antmicro/artix-dc-scm/assets/previews/layer0.png

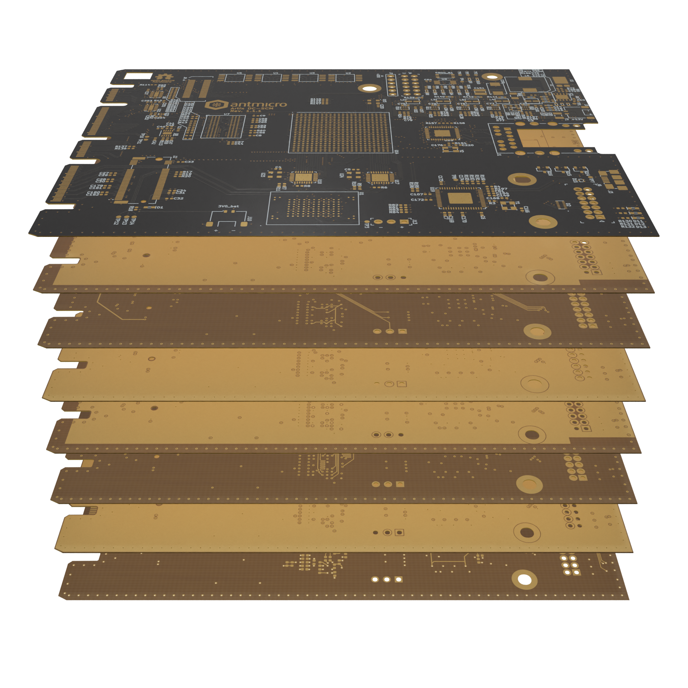
assets/previews/layer0.png
