antmicro/artix-dc-scm/assets/previews/layer1.png

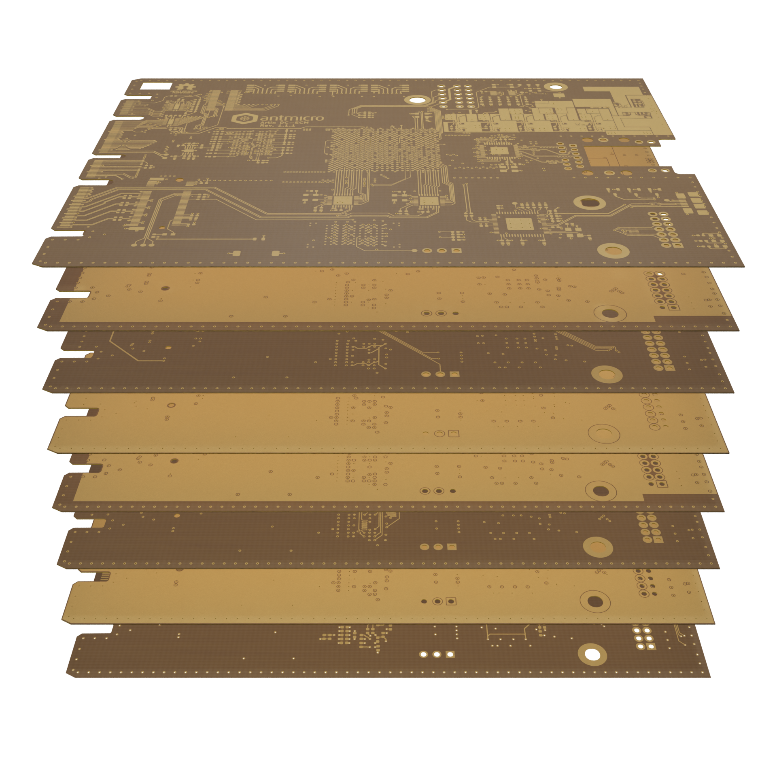
assets/previews/layer1.png
