antmicro/artix-dc-scm/assets/previews/layer1_thumbnail.png

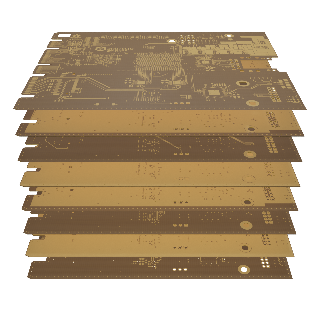
assets/previews/layer1_thumbnail.png
