antmicro/artix-dc-scm/assets/previews/layer2.png

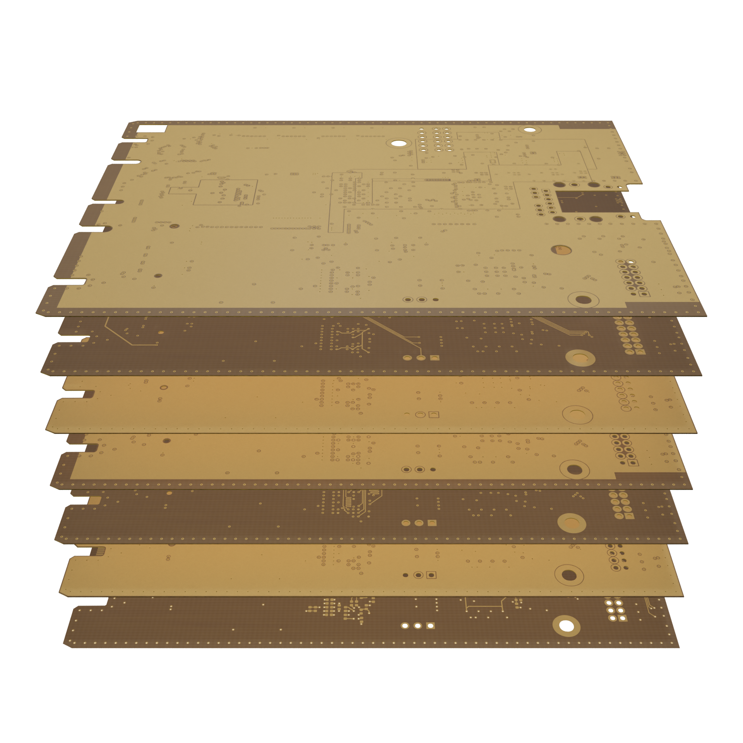
assets/previews/layer2.png
