antmicro/artix-dc-scm/assets/previews/layer3.png

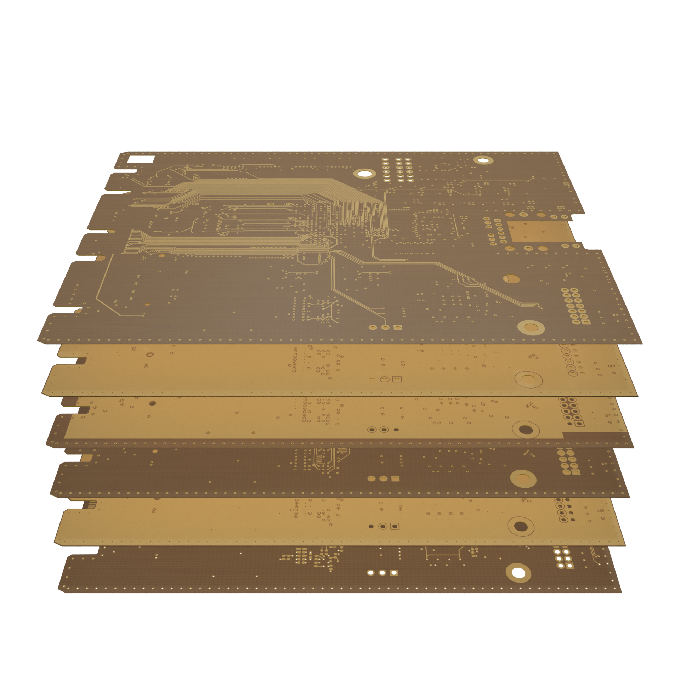
assets/previews/layer3.png
