antmicro/artix-dc-scm/assets/previews/layer3_thumbnail.png

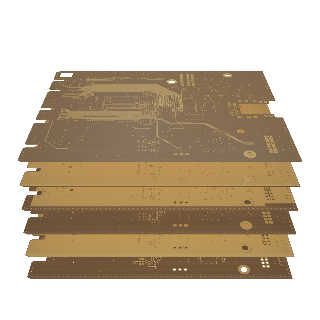
assets/previews/layer3_thumbnail.png
