antmicro/artix-dc-scm/assets/previews/layer4.png

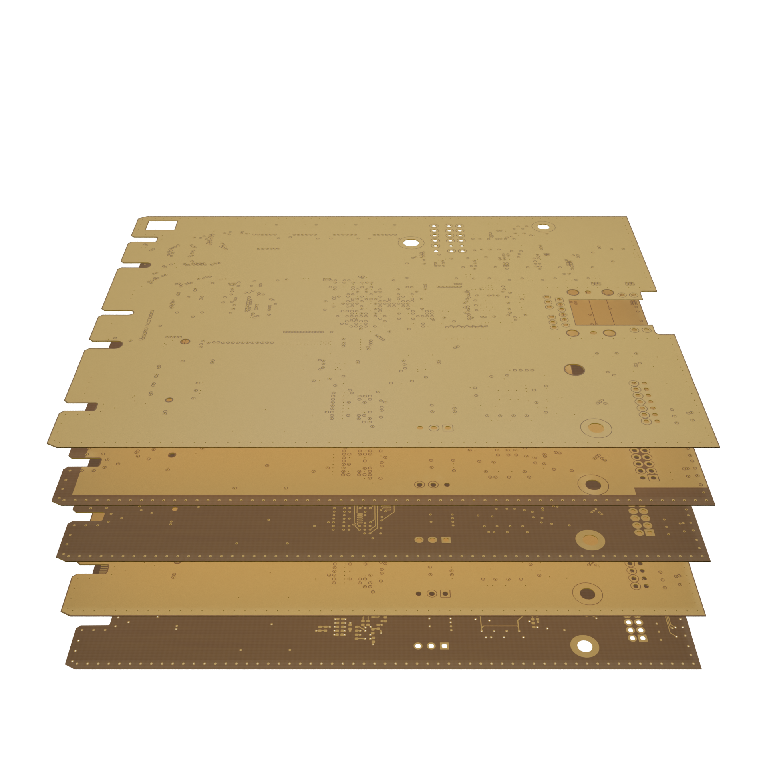
assets/previews/layer4.png
