antmicro/artix-dc-scm/assets/previews/layer6.png

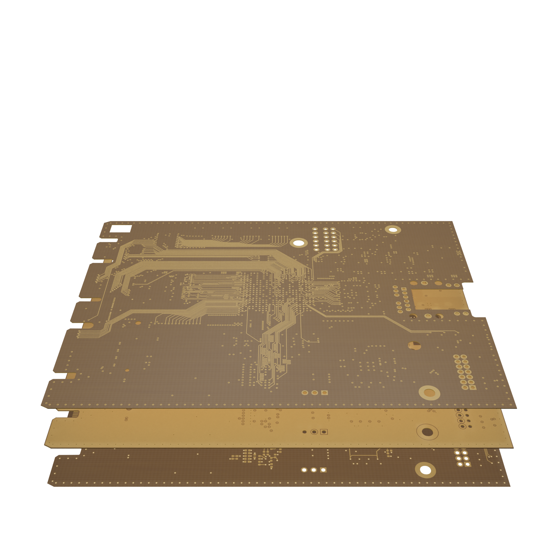
assets/previews/layer6.png
