antmicro/artix-dc-scm/assets/previews/layer7.png

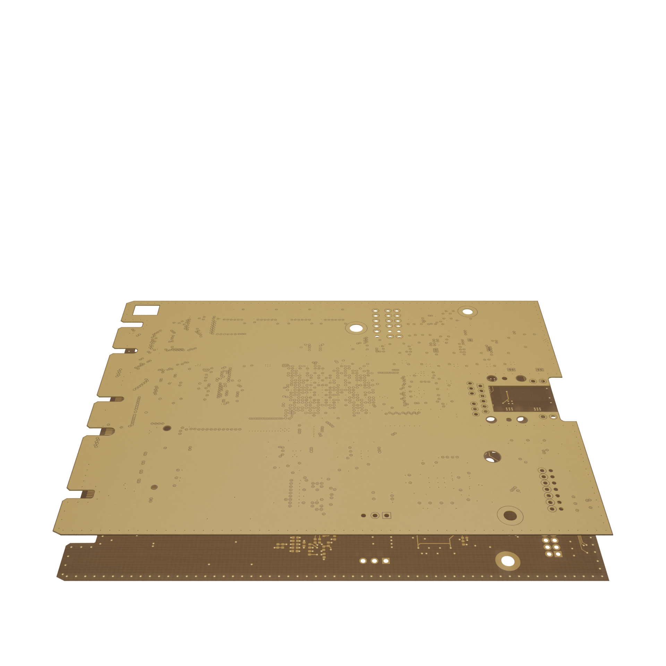
assets/previews/layer7.png
