antmicro/artix-dc-scm/assets/previews/layer8.png

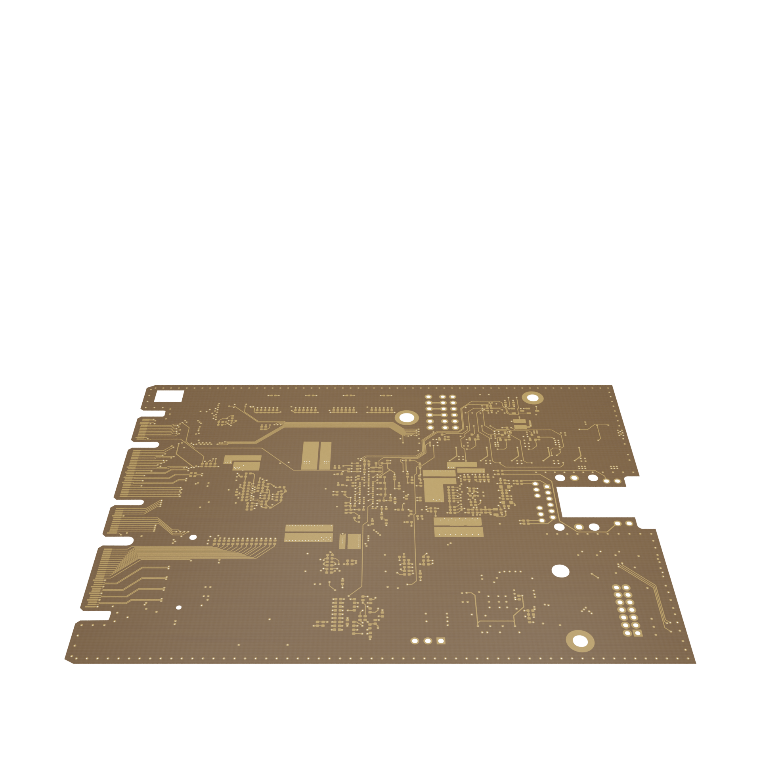
assets/previews/layer8.png
