antmicro/artix-dc-scm/assets/previews/leftB.png

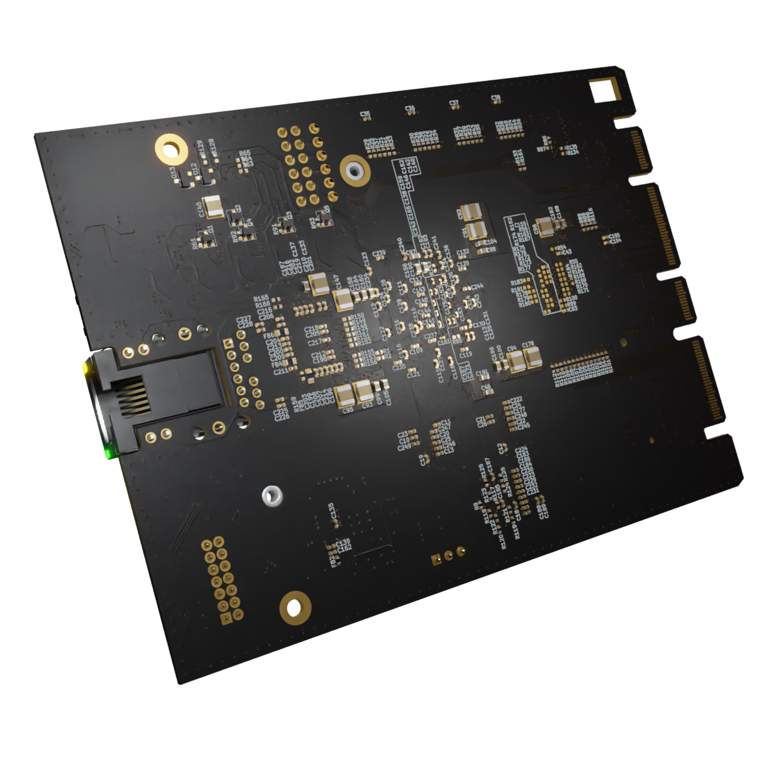
assets/previews/leftB.png
