antmicro/artix-dc-scm/assets/previews/leftT.png

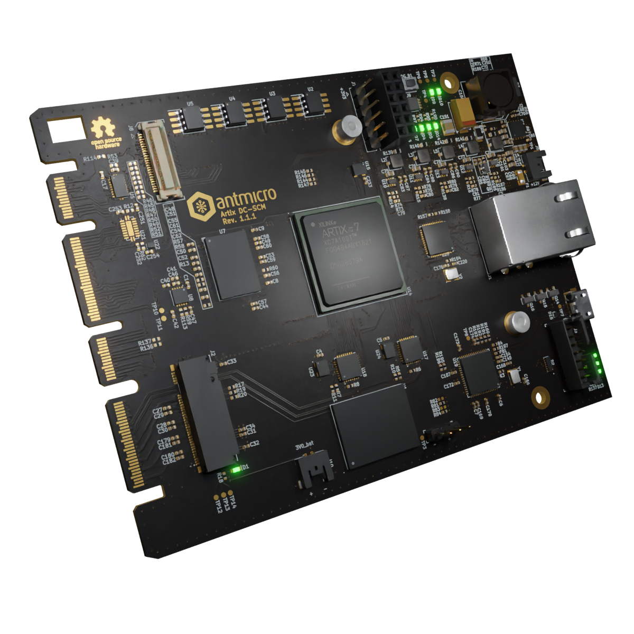
assets/previews/leftT.png
