antmicro/artix-dc-scm/assets/previews/orthoB.png

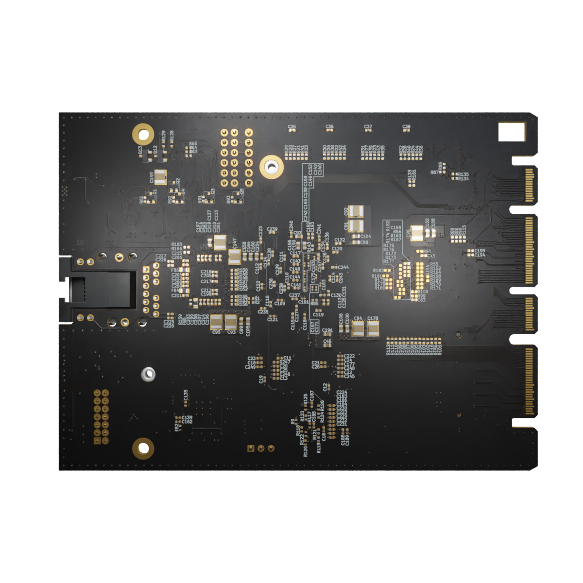
assets/previews/orthoB.png
