antmicro/artix-dc-scm/assets/previews/orthoT.png

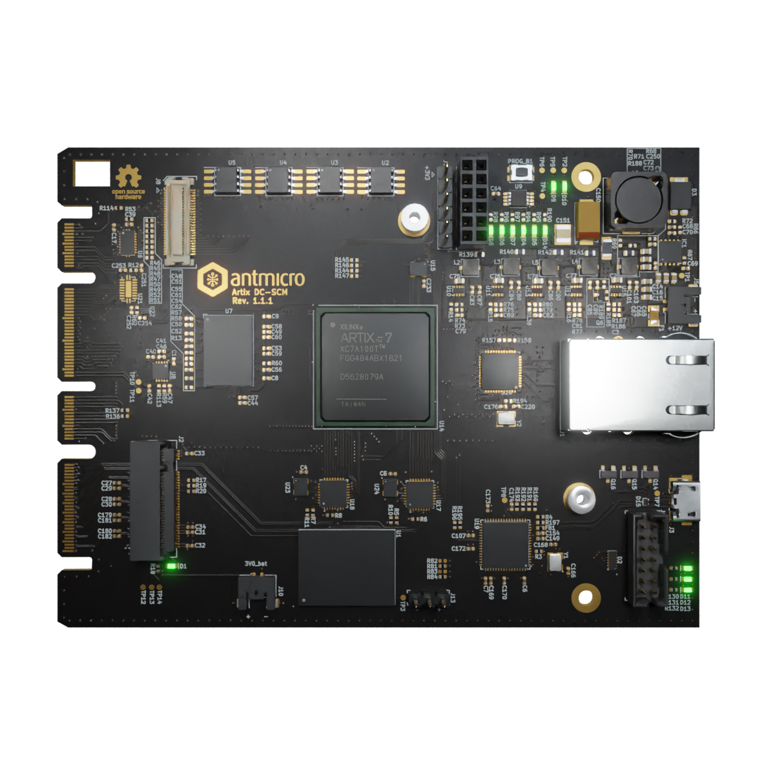
assets/previews/orthoT.png
