antmicro/artix-dc-scm/assets/previews/photoB.png

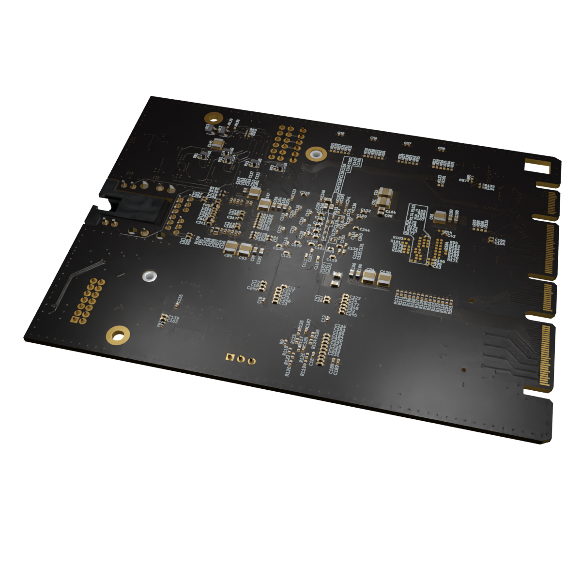
assets/previews/photoB.png
