antmicro/artix-dc-scm/assets/previews/photoT.png

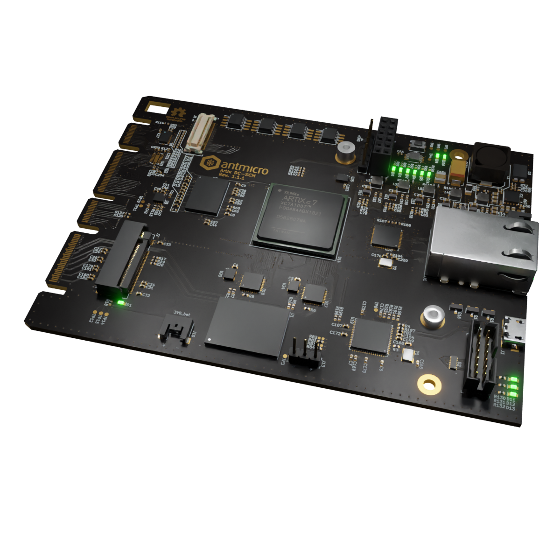
assets/previews/photoT.png
