antmicro/artix-dc-scm/assets/previews/rightB.png

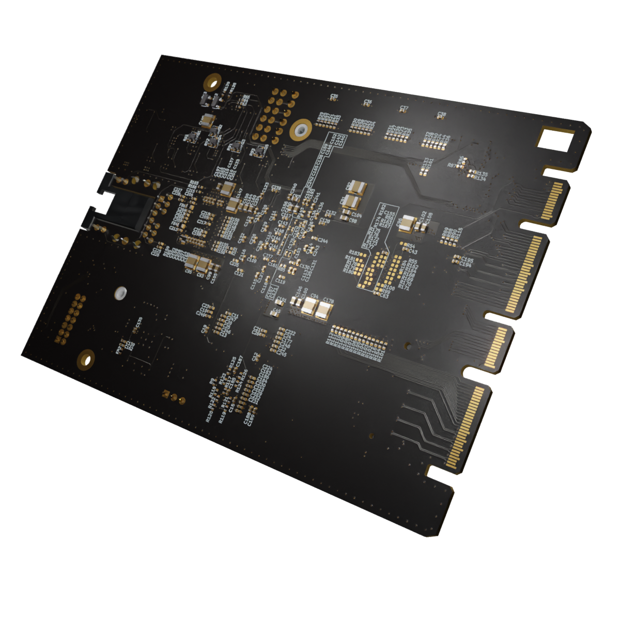
assets/previews/rightB.png
