antmicro/artix-dc-scm/assets/previews/rightT.png

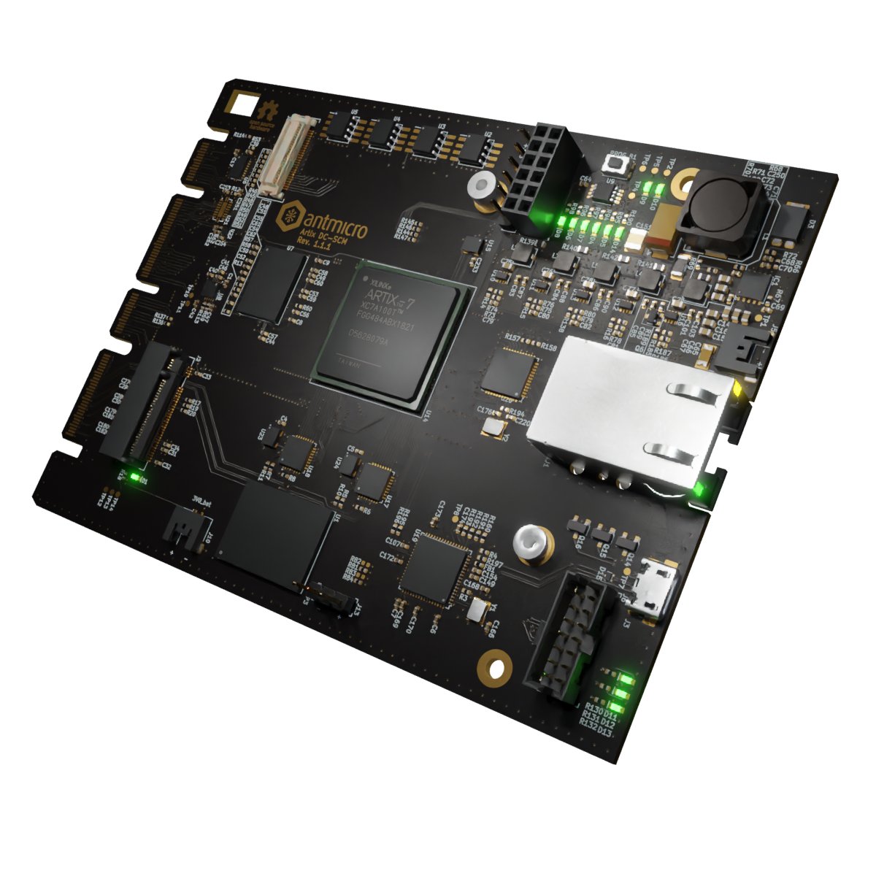
assets/previews/rightT.png
