antmicro/artix-dc-scm/img/diagram.png

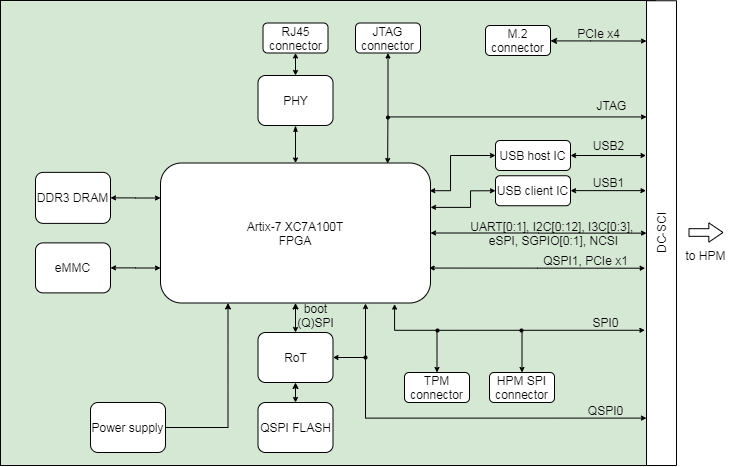
img/diagram.png
