antmicro/artix-dc-scm/(threads)

Thread 1 (2022-09-23):

i2c5 routed to incorrect DC-SCI pins, PCIe signals off-by-two

jk-ozlabs, 2022-09-23:
Firstly, thanks for the design! I really appreciate having the schematics and board layout open.

I'm having an issue with I2C5. In the DC-SCI spec, pins A11 and A12 are intended for I2C5:

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

However, the schematic has A11 grounded, and A12 connected to `PCIE_BMC_CLK_100_P` instead, and I2C5 is placed after the three differential pairs of PCIe signals:

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

It looks like the I2C5 pins are just on the wrong side of the PCIe set, and the PCIe signals should be shifted up by two.

We can work-around SDA in gateware, but SCL being grounded makes the i2c bus unusable without a hardware rework.

We're not using PCIe here, but this would also cause issues for those who might be.

jk-ozlabs, 2022-09-23:
Actually, I don't think we can't work-around SDA in gateware - that PCIe IO is pulling the line down to 1.8V.

pkatarzynski, 2022-09-23:
Hi jk-ozlabs

Thank you for your update - we will cross-check and update if needed.

jk-ozlabs, 2022-09-24:
Thanks @pkatarzynski ! I have a few other things to feedback on the design - mainly just enhancements. Would those be useful at all? (ie., are you planning to do another revision of this board in future?)

pkatarzynski, 2022-09-28:
Indeed there was a glitch in signal assignment. We have pushed a fix to that. Thank you for spotting this.

Actually we are doing quite a lot around BMC and server integration -  if you have any questions or suggestions, please shoot us an email using contact@antmicro.com

Closed 2022-09-28.

Thread 3 (2022-10-14):

Feature request: i2c/SMBus signals routed to M.2 connector

jk-ozlabs, 2022-10-14:
Since there is the M.2 connector on the DC-SCM board, it would be nice to be able to perform out-of-band management of NVMe devices, using either the NVMe-MI or NVMe basic management protocols.

This would just be a matter of connecting the `SMB_DATA` (pin 42) and `SMB_CLOCK` (pin 40) signals of `J2` to a couple of IO pins of the Artix. the SMBus alert signal shouldn't be needed for NVMe management.

The M.2 spec defines these as 1.8V signals, so they'd either need to go through a translator, or could we potentially use a separate Artix IO bank running at 1.8V?

We have implemented a bunch of NVMe-MI (over MCTP over i2c) infrastructure for existing BMCs already, and have it working with M.2 devices - would be useful to be able to do this on the DC-SCM board too.
