antmicro/artix-dc-scm/doc/artix-dc-scm.pdf

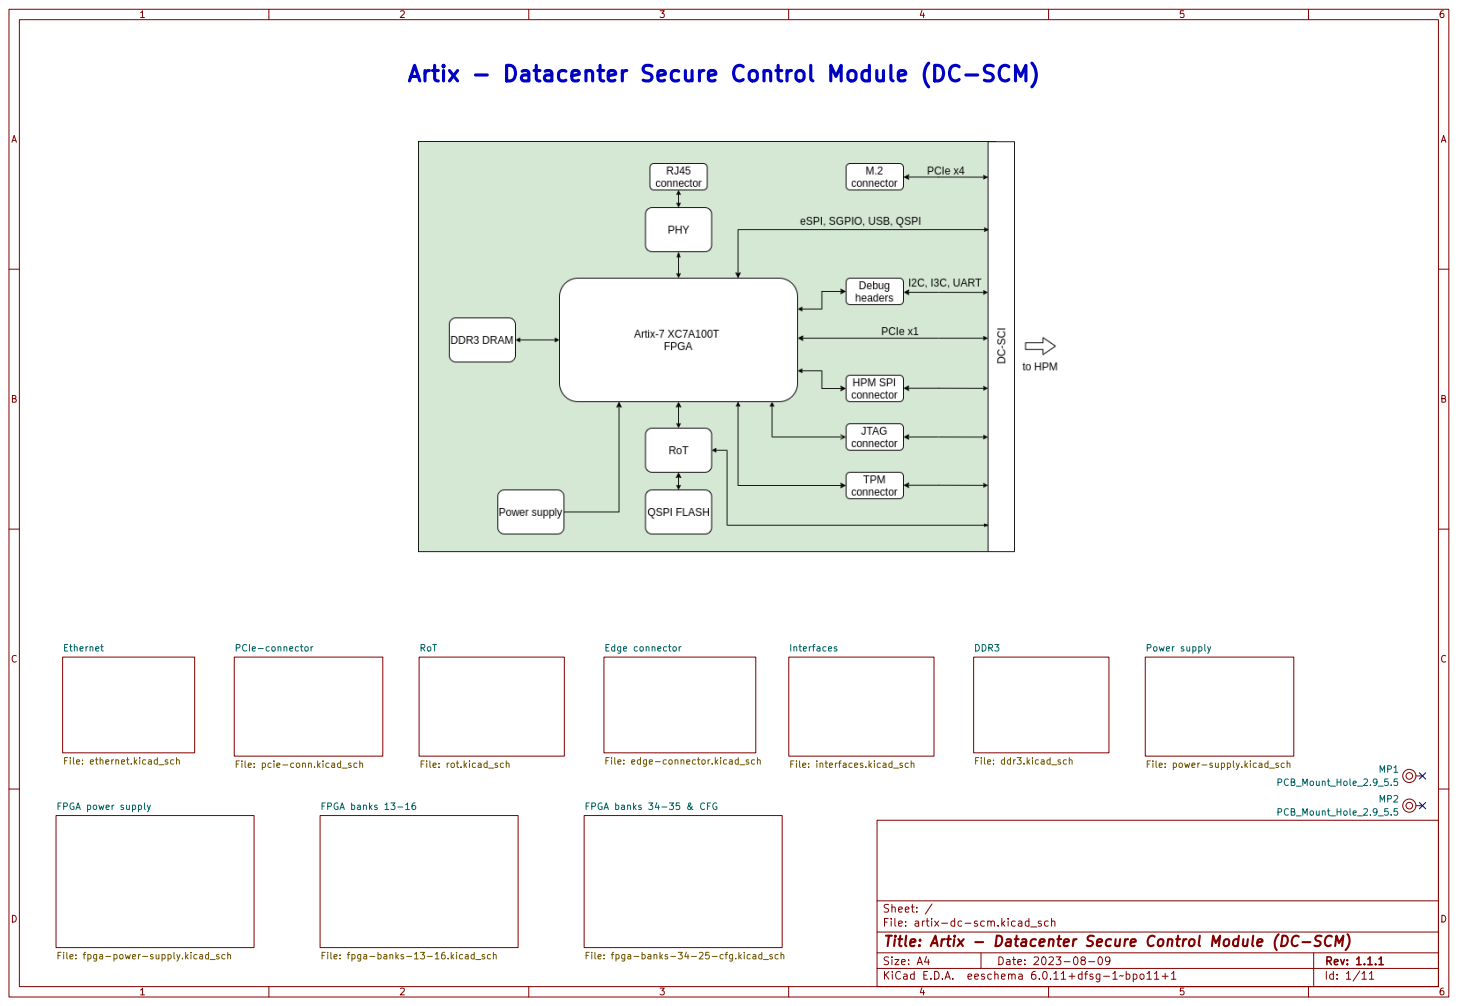
[picture p22: page 1]

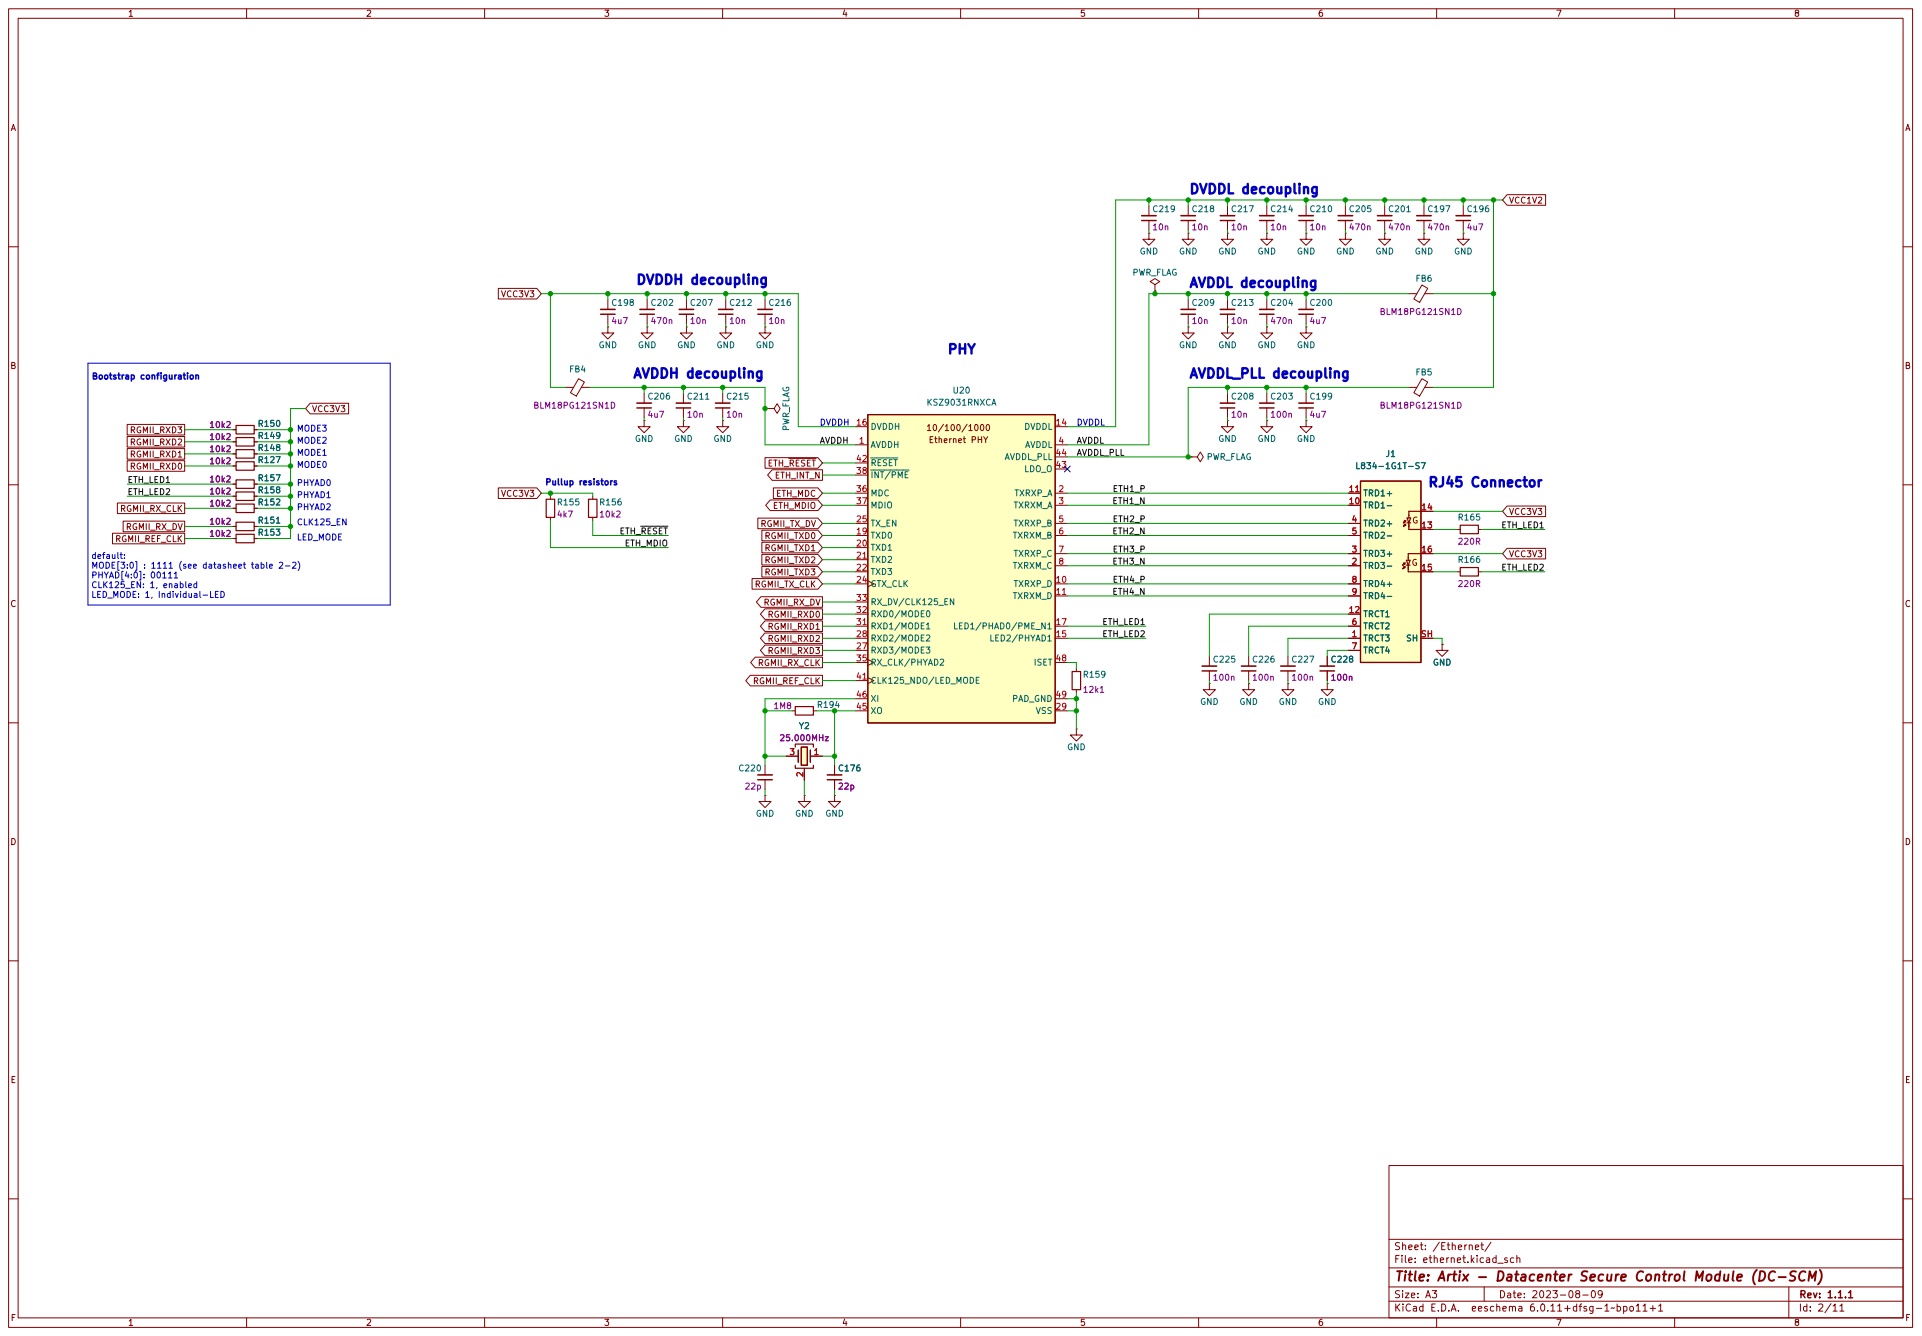
[picture p23: page 2]

Id: 2/11 Title: Artix - Datacenter Secure Control Module (DC-SCM) File: ethernet.kicad_sch Sheet: /Ethernet/

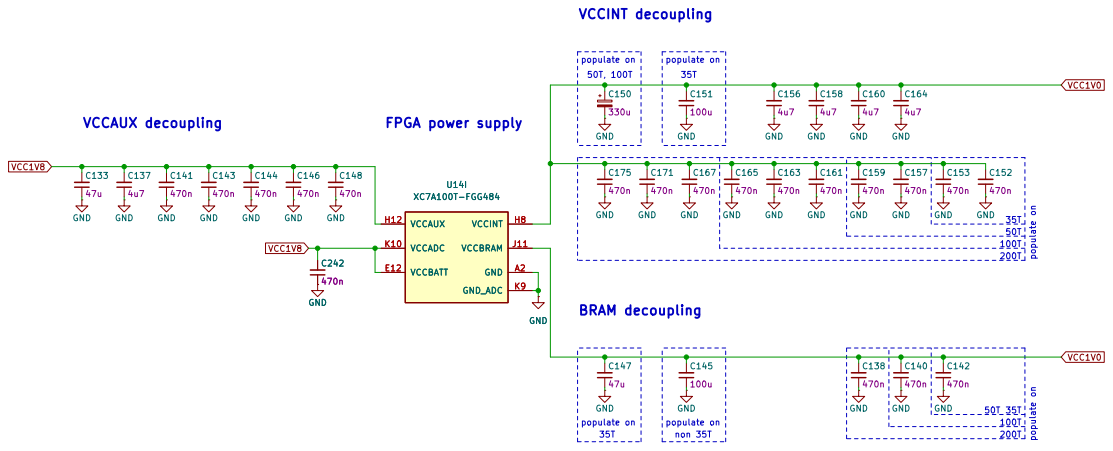
[picture p24: page 3]

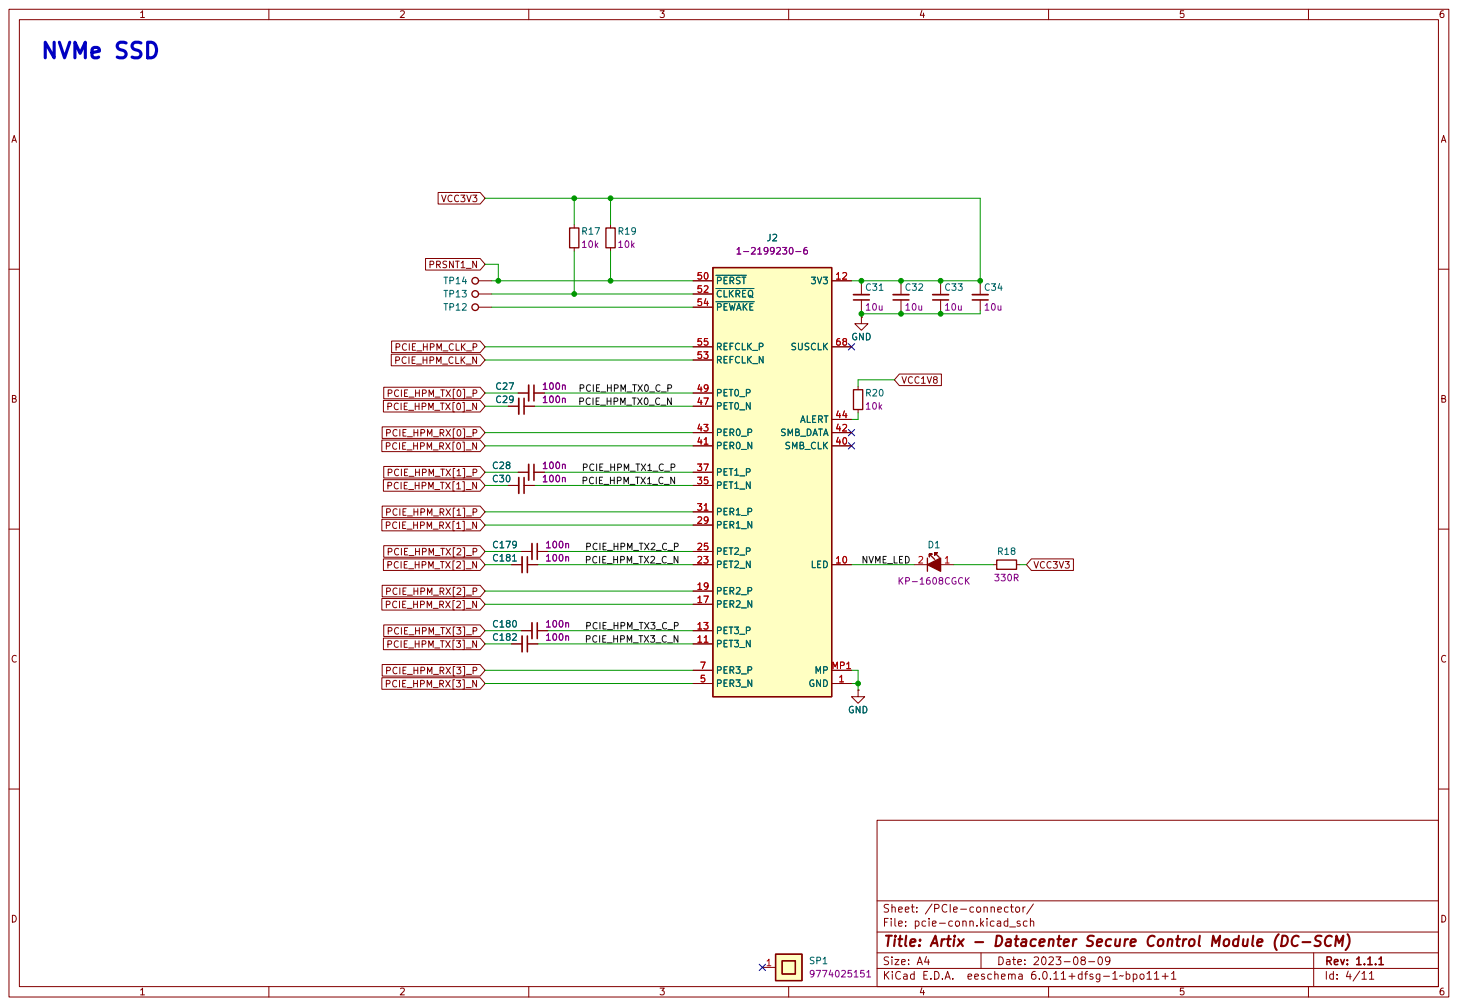
[picture p25: page 4]

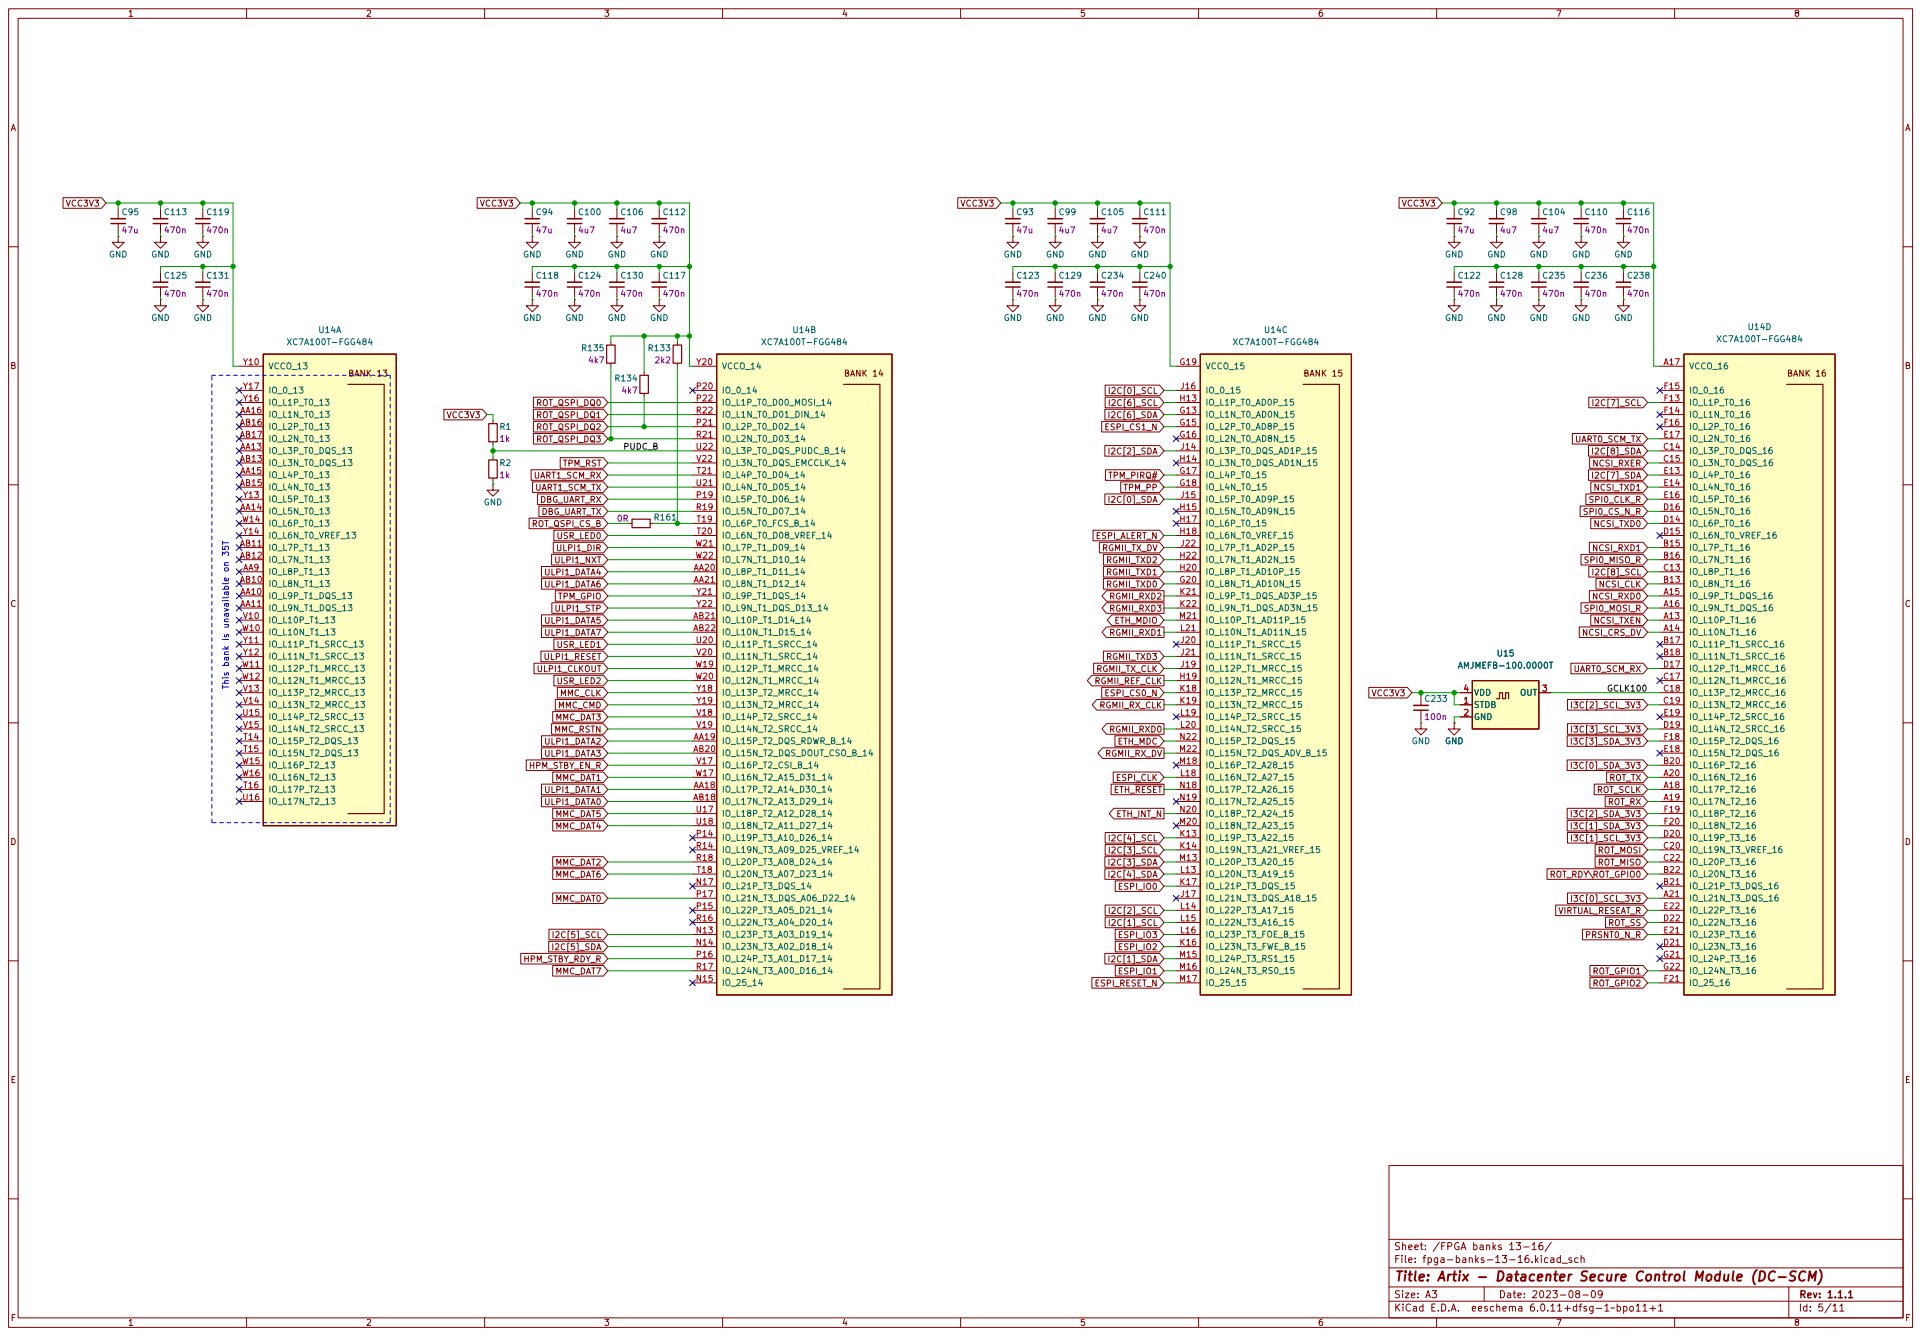
[picture p26: page 5]

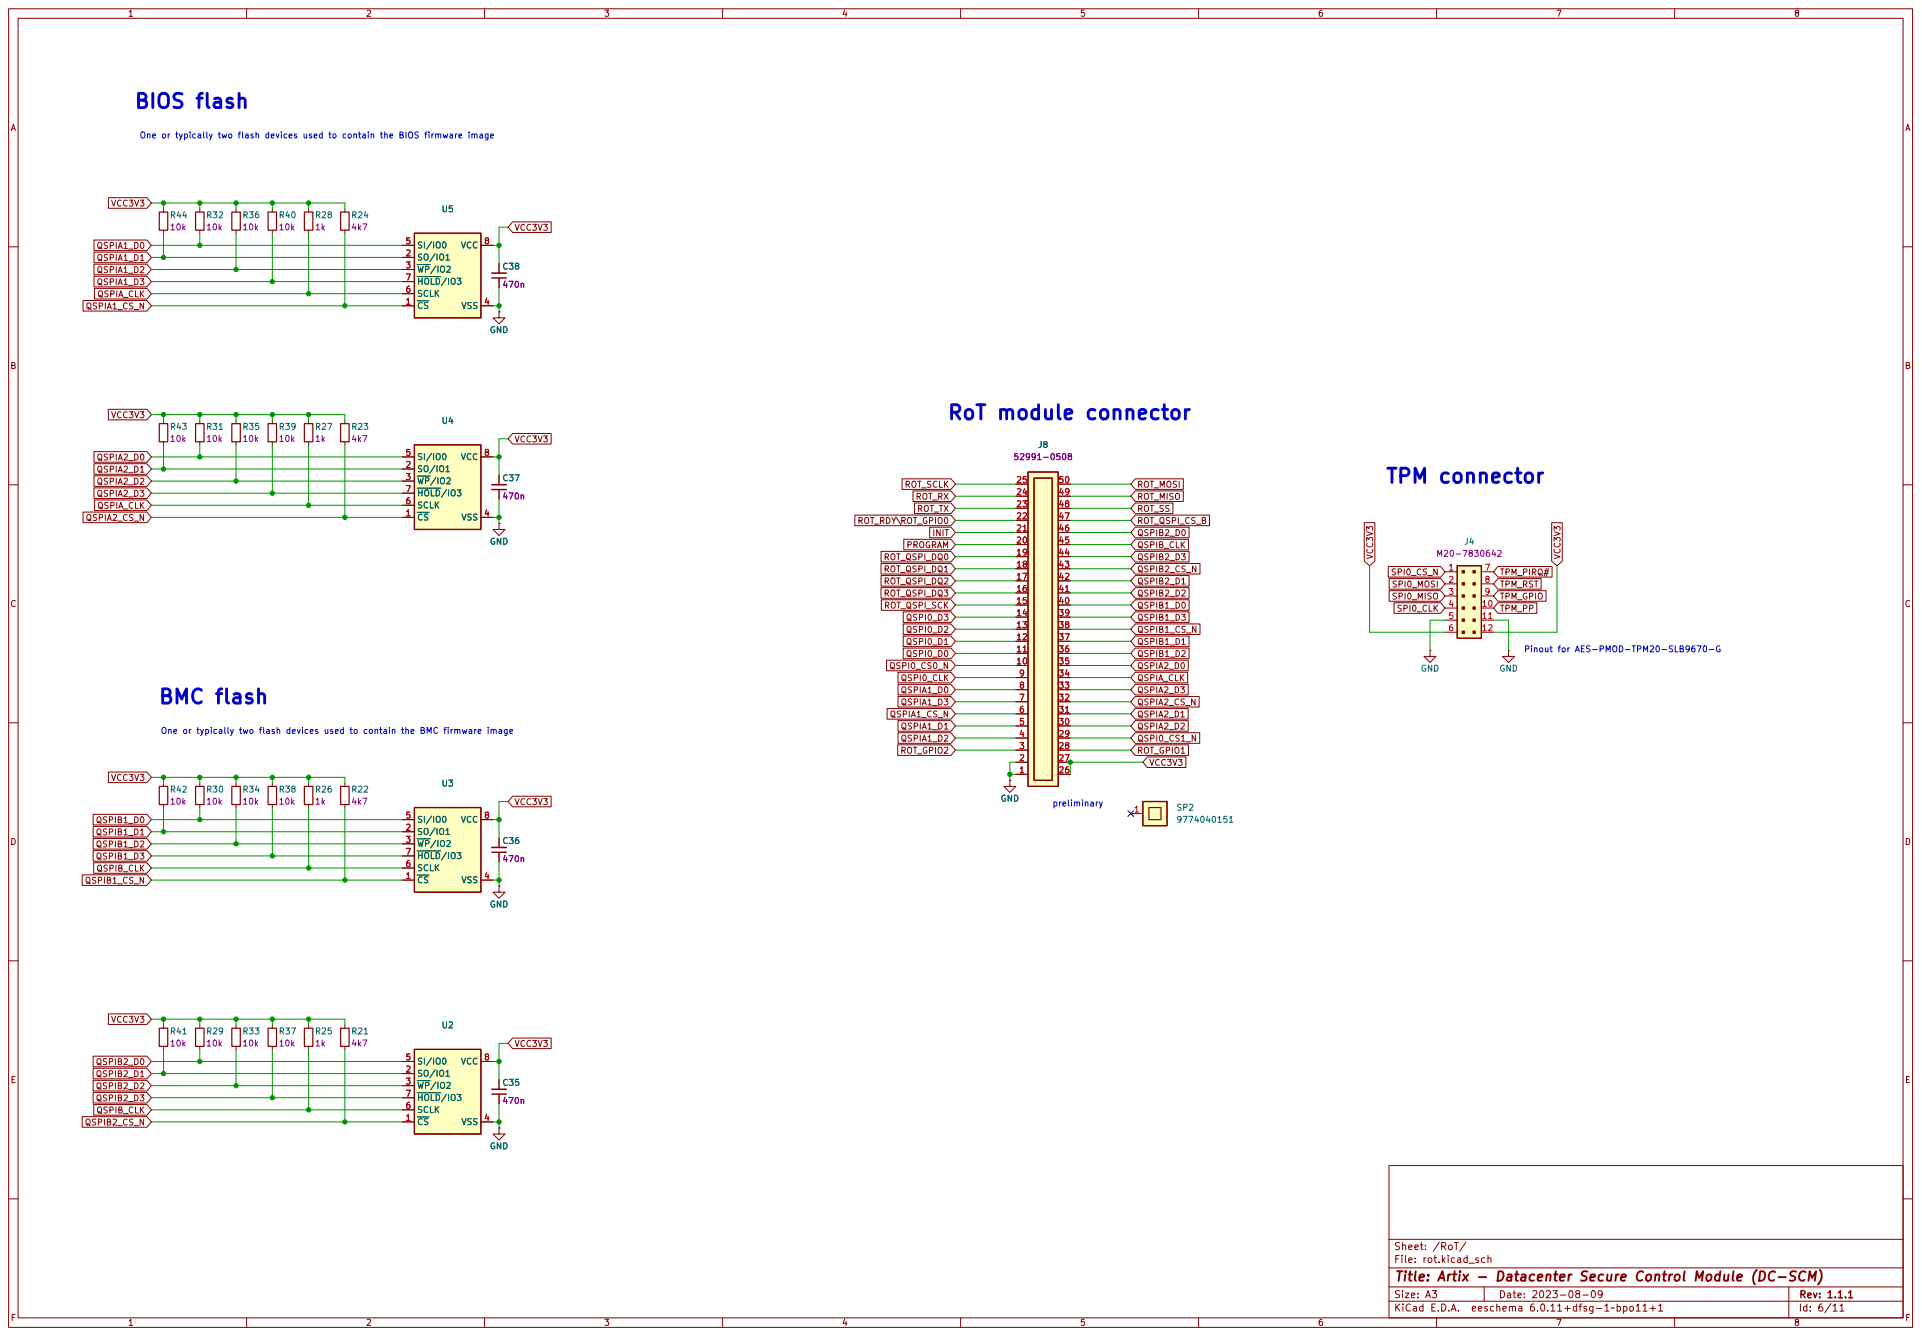
[picture p27: page 6]

Pinout for AES-PMOD-TPM20-SLB9670-G BIOS flash

Id: 6/11 Title: Artix - Datacenter Secure Control Module (DC-SCM) File: rot.kicad_sch Sheet: /RoT/

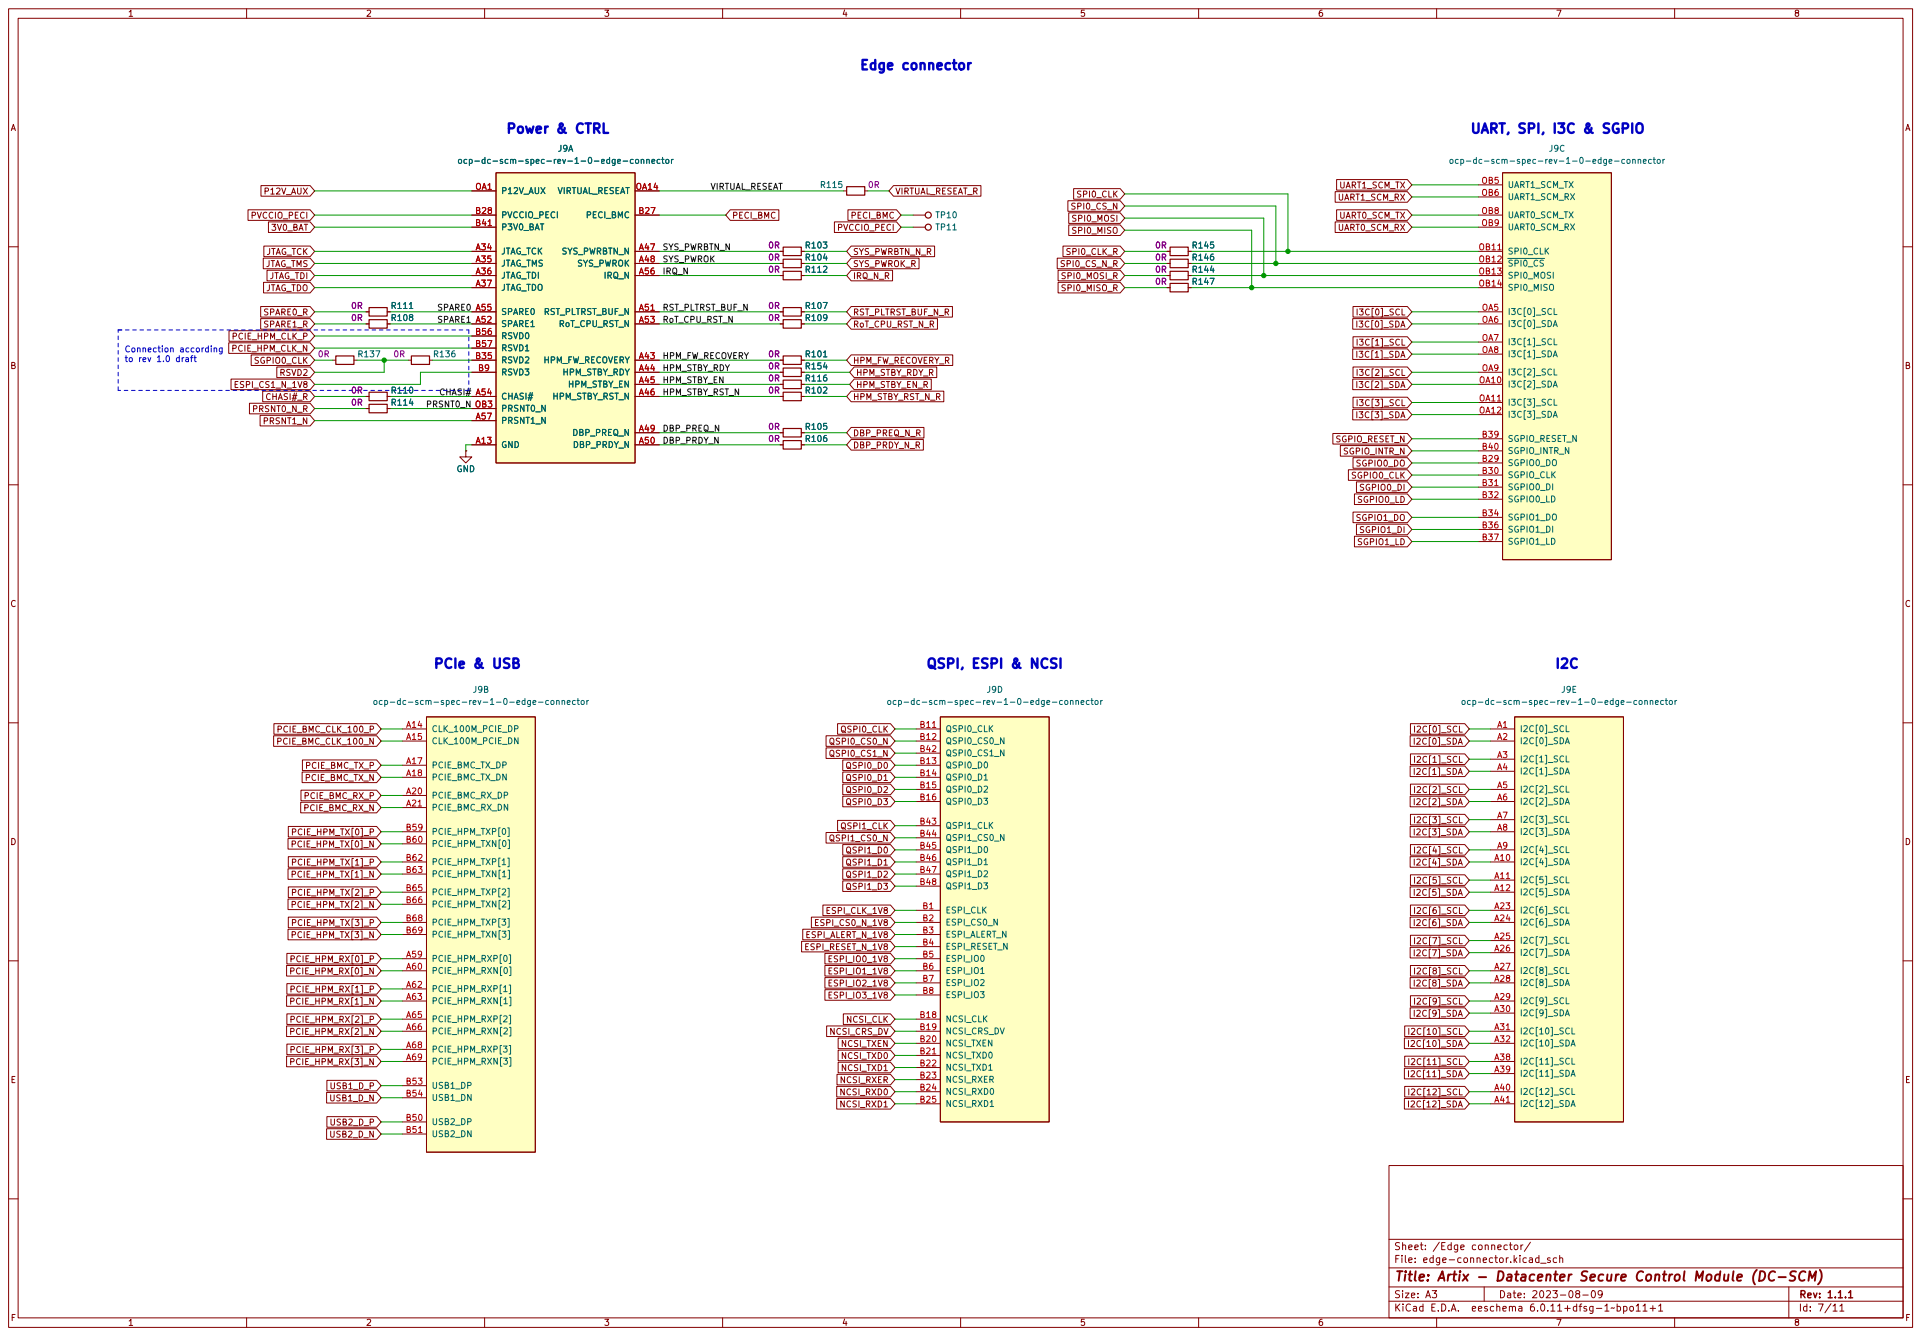
[picture p28: page 7]

ocp-dc-scm-spec-rev-1-0-edge-connector GND A13

ocp-dc-scm-spec-rev-1-0-edge-connector

Id: 7/11 Title: Artix - Datacenter Secure Control Module (DC-SCM) File: edge-connector.kicad_sch Sheet: /Edge connector/

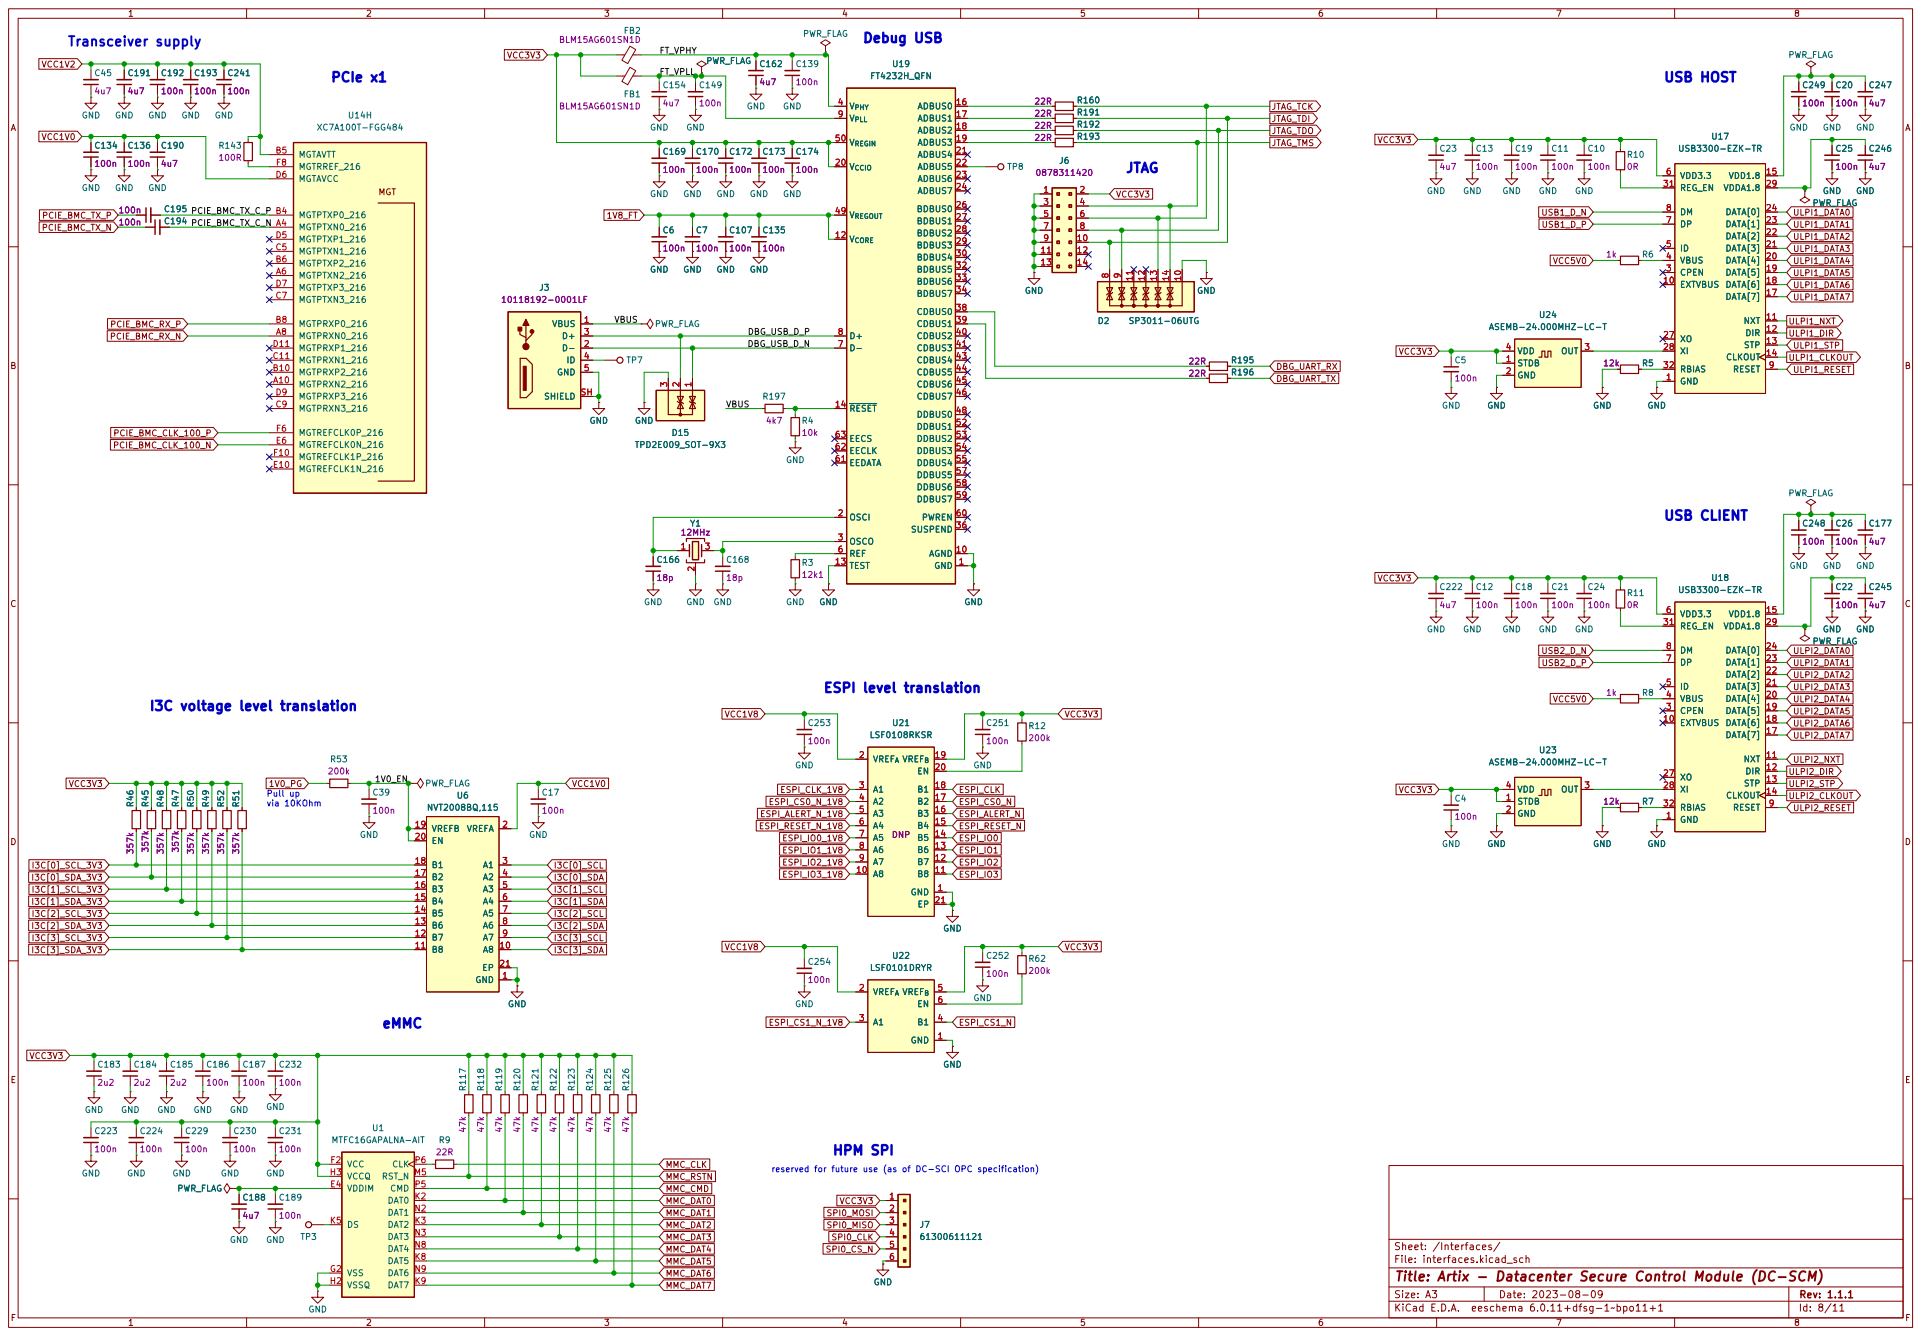
[picture p29: page 8]

HPM SPI Pull up
via 10KOhm

reserved for future use (as of DC-SCI OPC specification)

Id: 8/11 Title: Artix - Datacenter Secure Control Module (DC-SCM) File: interfaces.kicad_sch Sheet: /Interfaces/

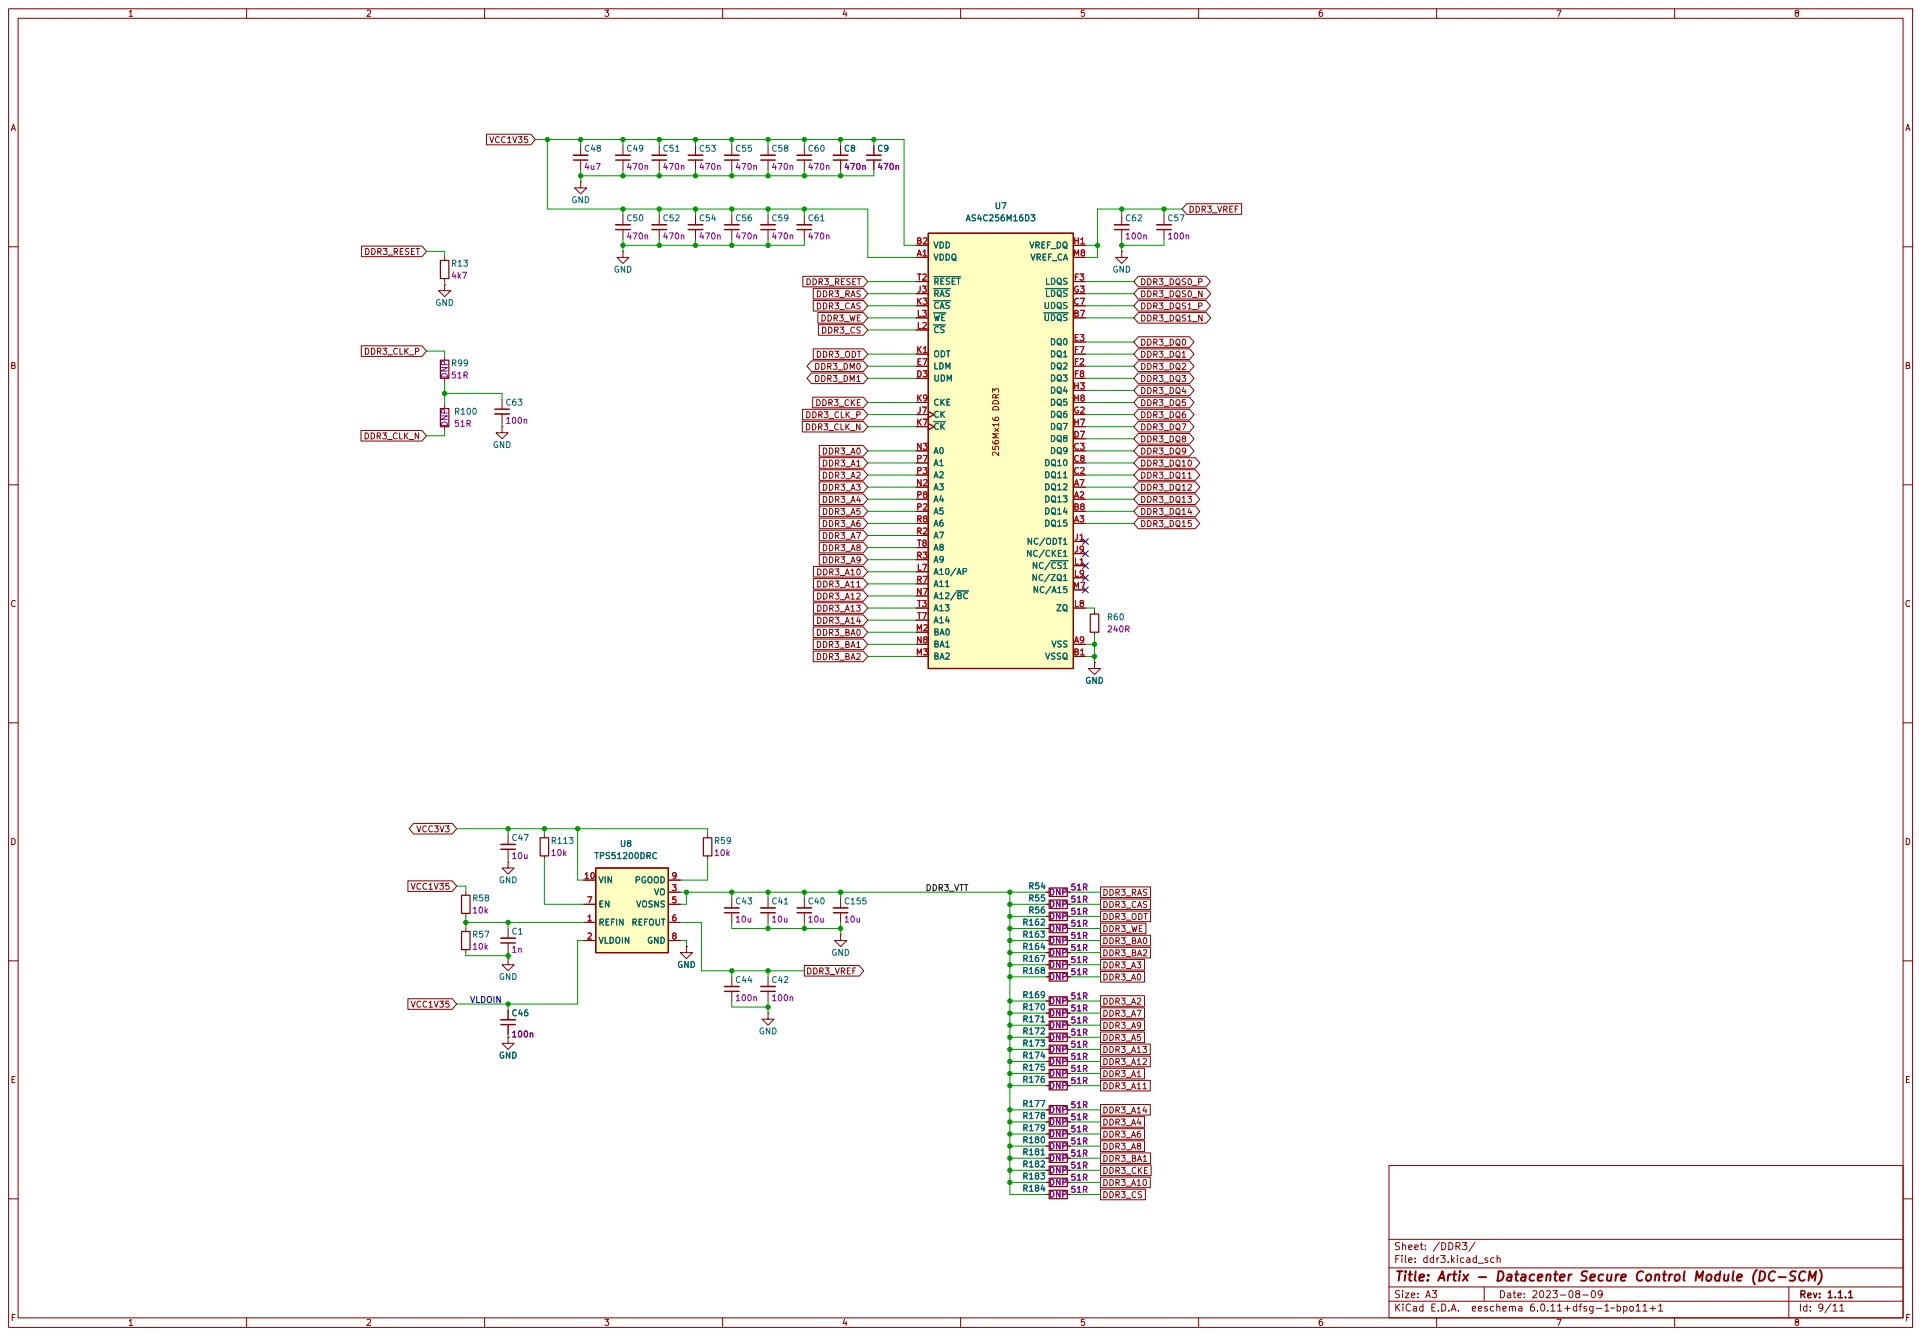
[picture p30: page 9]

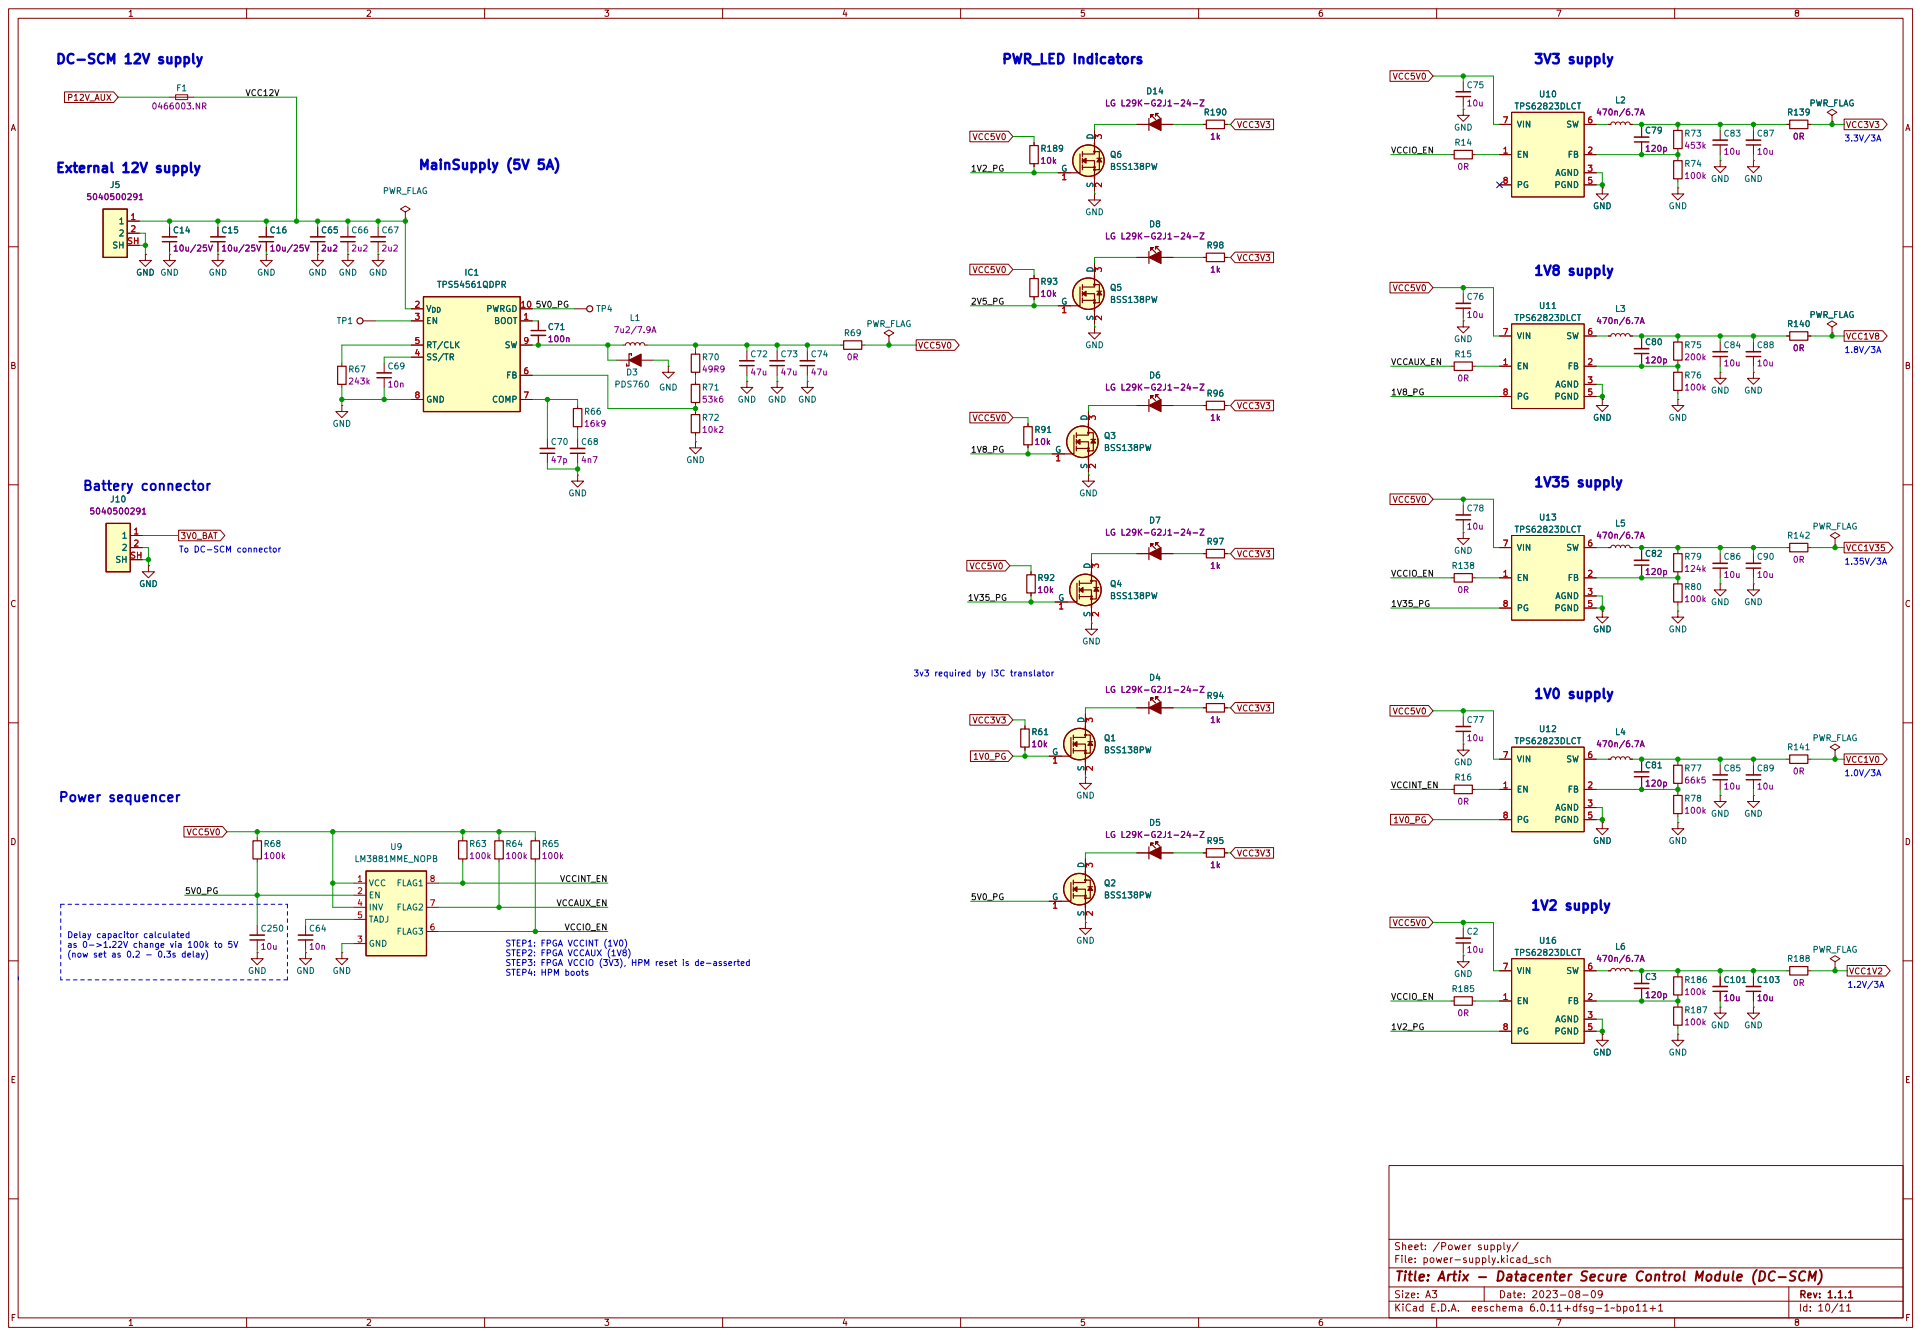
[picture p31: page 10]

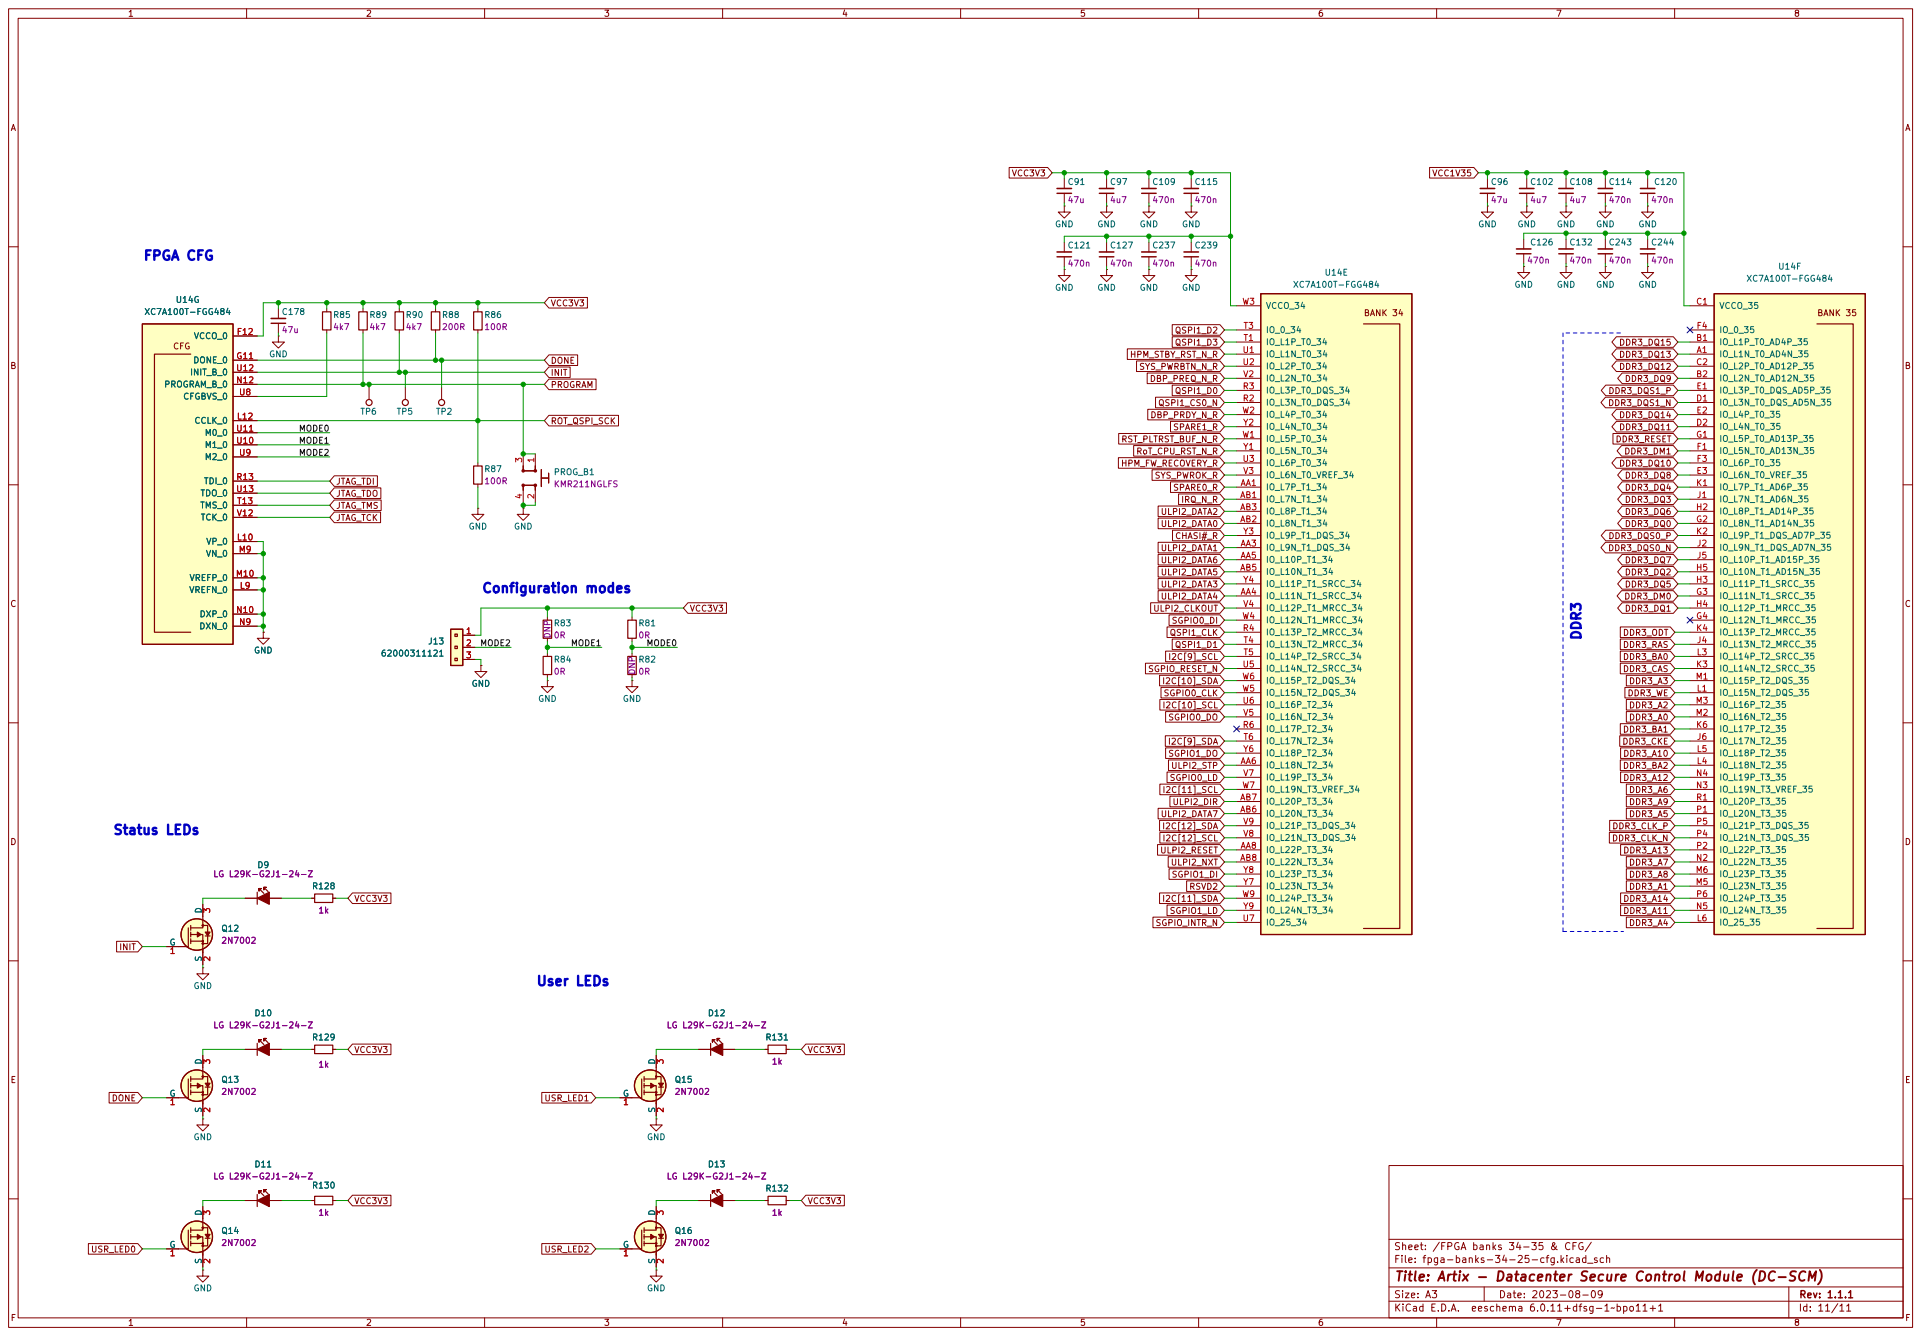
[picture p32: page 11]
