antmicro/artix-dc-scm/artix-dc-scm.kicad_pcb

## KiCad design artix-dc-scm.kicad_pcb (2021-01-07)

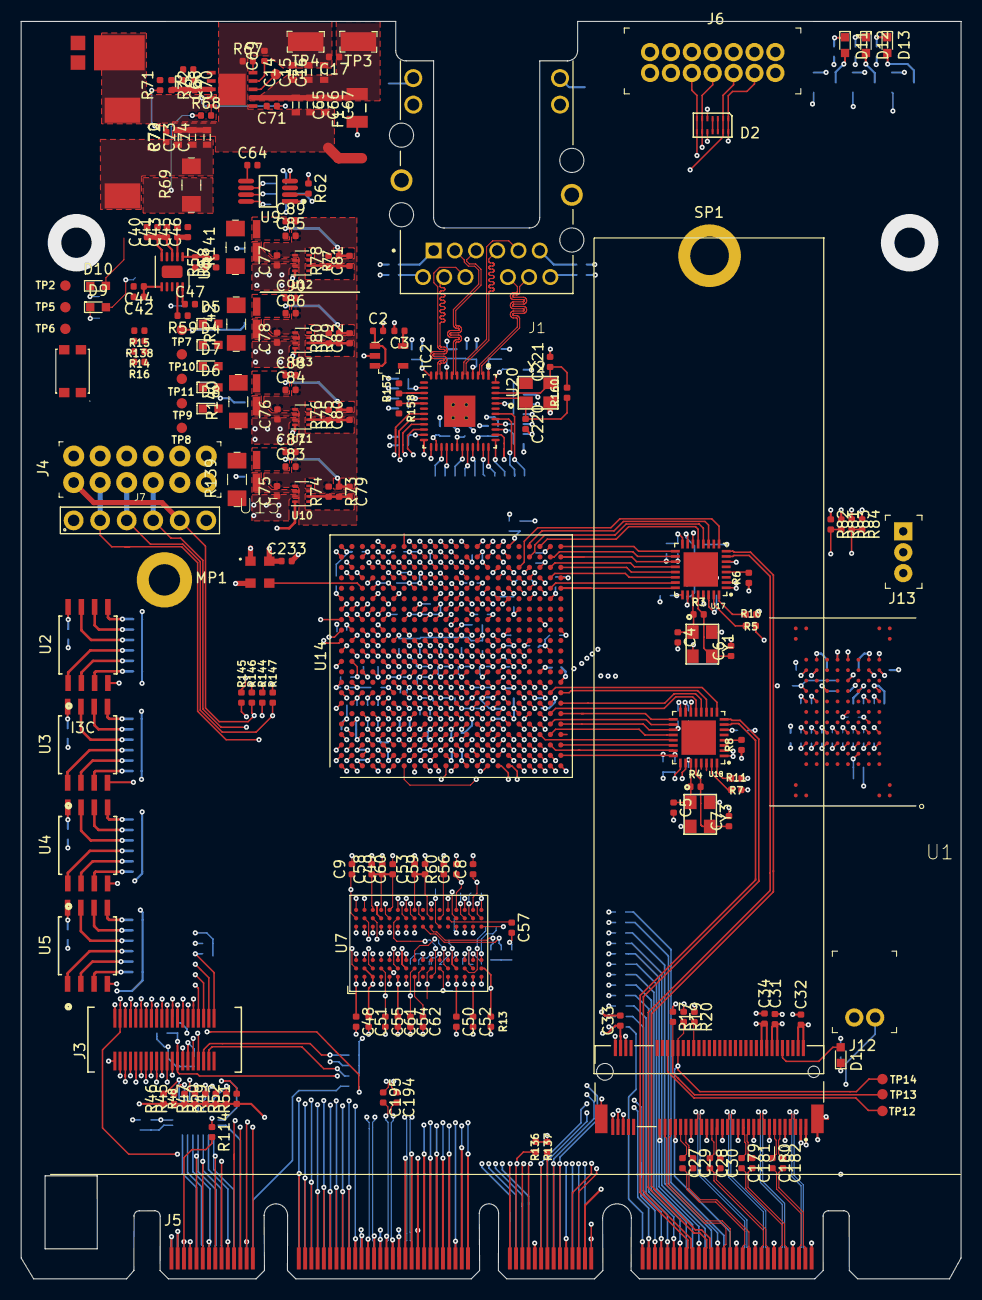
[picture p33: board artix-dc-scm.kicad_pcb from above]

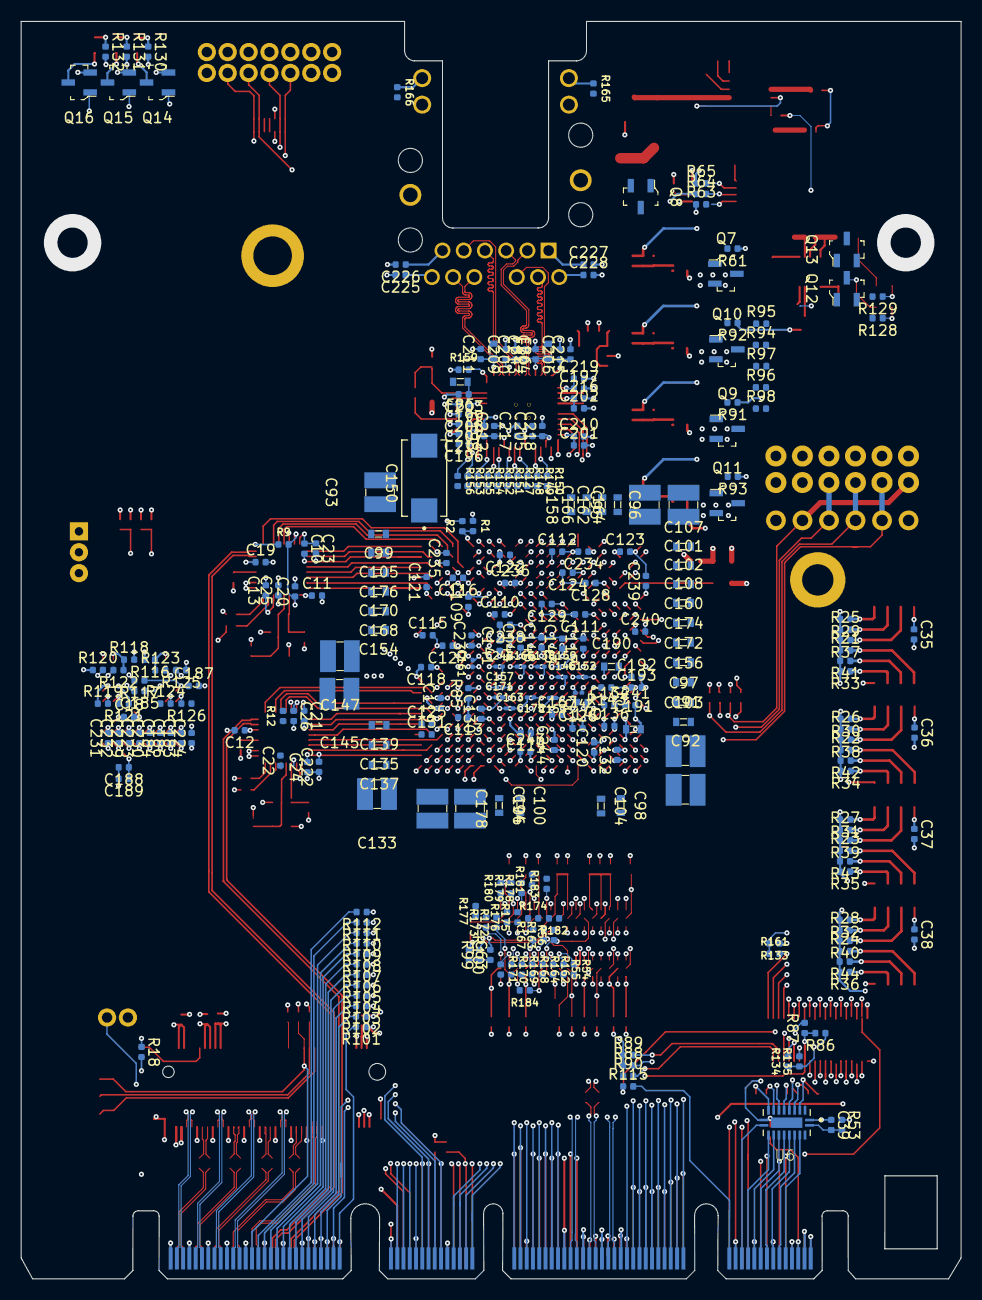
[picture p34: board artix-dc-scm.kicad_pcb from below]

Board: 8 copper layers, 90.0 x 120.4 mm, 502 parts (293 on the bottom side), 427 nets.

Parts:
C1: C_1n_0402; 0402-res
C2, C3: C_1u_0402; 0402-cap
C4, C5, C6, C7: C_12p_0402; 0402-cap
C8, C9, C35, C36, C37, C38, C49, C50, C51, C52, C53, C54, C55, C56, C58, C59, C60, C61, C109, C110, C111, C112, C113, C114, C115, C116, C117, C118, C119, C120, C121, C122, C123, C124, C125, C126, C127, C128, C129, C130, C131, C132, C140, C141, C143, C144, C148, C167, C197, C201, C202, C204, C205, C234, C235, C236, C237, C238, C239, C240, C243, C244: C_470n_0402; 0402-cap
C10, C11, C12, C13, C18, C19, C20, C21, C22, C24, C25, C26, C27, C28, C29, C30, C39, C42, C44, C45, C46, C57, C62, C63, C71, C134, C136, C179, C180, C181, C182, C186, C187, C189, C192, C193, C194, C195, C203, C223, C224, C225, C226, C227, C228, C229, C230, C231, C232, C233, C241: C_100n_0402; 0402-cap
C14, C15, C16: C_10u_25V_0603; 0603-cap
C17: C_100n_0402_16V; 0402-cap
C23, C48, C188, C196, C198, C199, C200, C206, C222: C_4u7_0402; 0402-cap
C31, C32, C33, C34, C40, C41, C43, C47, C75, C76, C77, C78, C83, C84, C85, C86, C87, C88, C89, C90: C_10u_0402; 0402-cap
C64, C69, C207, C208, C209, C210, C211, C212, C213, C214, C215, C216, C217, C218, C219: C_10n_0402; 0402-cap
C65, C66, C67: C_2u2_0603_25V; 0603-cap
C68: C_4n7_0402; 0402-cap
C70: C_47p_0402; 0402-cap
C72, C73, C74: C_47u_0603; 0603-cap
C79, C80, C81, C82: C_120p_0402; 0402-res
C91, C92, C93, C94, C95, C96, C133, C147, C178: C_47u_1210; 1210-cap
C97, C98, C99, C100, C101, C102, C103, C104, C105, C106, C107, C108, C135, C137, C139, C154, C156, C158, C160, C162, C164, C166, C168, C170, C172, C174, C176, C190, C191: C_4u7_0603; 0603-cap
C138, C142, C146, C152, C153, C157, C159, C161, C163, C165, C171, C175, C242: C_470n_0402; 0201-res
C145: C_100u_1210; 1210-cap
C150: C_330u_KEMET_D; KEMET_D
C183, C184, C185: C_2u2_0402; 0402-cap
C220, C221: C_22p_0402; 0402-cap
D1: KP-1608CGCK; LED_0603
D2: TPD6E05U06
D3: PDS760-13
D4, D5, D6, D7, D8, D9, D10, D11, D12, D13: LG_L29K-G2J1-24-Z; LED_0603
F1: 0466003.NR; 1206-Fuse-Littelfuse-0466-0-0-MFG
FB4, FB5, FB6: BLM18PG121SN1D; 0603-res
IC1: TPS54561; WSON-10_4x4
IC2: TLV73312PDBVT; SOT-23-5
J1: L834-1G1T-S7; BEL_L834-1G1T-S7
J2: 1-2199230-6
J3: 529910408
J4: M20-7830642; PinHeader_6x2_P2.54mm_Vertical
J5: SFF-TA-1002-4C+
J6: 0878311420; PinHeader_2x7_P2mm_Drill1mm
J7: 61300611121
J12: S2B-PH-K-S_LF__SN_; PinHeader_1x2_P2mm_Drill1mm_RA
J13: 62000311121
L1: WE_7447798720
L2, L3, L4, L5: IHLP1212AEERR47M11; IHLP-1212AE
MP1: PCB_Spacer_M2; 9774030243R
PROG_B1: KMR2; SW_SPST_4.2x2.8
Q7, Q8, Q9, Q10, Q11, Q12, Q13, Q14, Q15, Q16: 2N7002; SOT-23-3
R1, R2, R6, R8, R25, R26, R27, R28, R62, R63, R64, R65, R94, R95, R96, R97, R98, R128, R129, R130, R131, R132: R_1k_0402; 0402-res
R3, R4: R_1M5_0402; 0402-res
R5, R7: R_12k_0402; 0402-res
R9, R10, R11, R12, R14, R15, R16, R81, R82, R83, R84, R101, R102, R103, R104, R105, R106, R107, R108, R109, R110, R111, R112, R114, R115, R136, R137, R138, R144, R145, R146, R147, R161: R_0R_0402; 0402-res
R13, R21, R22, R23, R24, R85, R89, R90, R134, R135: R_4k7_0402; 0402-res
R17, R19, R20, R29, R30, R31, R32, R33, R34, R35, R36, R37, R38, R39, R40, R41, R42, R43, R44, R57, R58, R59, R61, R91, R92, R93, R116, R117, R118, R119, R120, R121, R122, R123, R124, R125, R126: R_10k_0402; 0402-res
R18: R_330R_0402; 0402-res
R45, R46, R47, R48, R49, R50, R51, R52: R_357k_0402; 0402-res
R53, R75: R_200k_0402; 0402-res
R54, R55, R56, R99, R100, R162, R163, R164, R167, R168, R169, R170, R171, R172, R173, R174, R175, R176, R177, R178, R179, R180, R181, R182, R183, R184: R_51R_0402; 0402-res
R60: R_240R_0402; 0402-res
R66: R_16k9_0402; 0402-res
R67: R_243k_0402; 0402-res
R68, R74, R76, R78, R80: R_100k_0402; 0402-res
R69, R139, R140, R141, R142: R_0R_1206; 1206-res
R70: R_49R9_0402; 0402-res
R71: R_53k6_0402; 0402-res
R72, R127, R148, R149, R150, R151, R152, R153, R154, R155, R156, R157, R158: R_10k2_0402; 0402-res
R73: R_453k_0402; 0402-res
R77: R_66k5_0402; 0402-res
R79: R_124k_0402; 0402-res
R86, R87, R143: R_100R_0402; 0402-res
R88: R_200R_0402; 0402-res
R133: R_2k2_0402; 0402-res
R159: R_12k1_0402; 0402-res
R160: R_1M8_0402; 0402-res
R165, R166: R_220R_0402; 0402-res
SP1: 9774025151
TP1, TP2, TP5, TP6, TP7, TP8, TP9, TP10, TP11, TP12, TP13, TP14: TP_SMD1MM; Testpoint_smd_1mm
TP3, TP4: RCW-0C; PROBE_PAD_1206
U1: MTFC16GAPALNA-AIT; BGA100CP100_17X10_1800X1400X140B46N
U2, U3, U4, U5: W25Q32JVSSIQ_TR; W25Q32JVSSIQ
U6: NVT2008DQ,115; QFN50P250X450X100-21N
U7: AS4C256M16D3; BGA-96_9.0x13.0mm_Layout2x3x16_P0.8mm
U8: TPS51200DRC; VSON-10-1EP_3x3mm
U9: LM3881MME_NOPB; VSSOP8-Texas_Instruments-DGK0008A
U10, U11, U12, U13: TPS62823DLCT; QFN-8_2x1mm
U14: XC7A100T-FGG484; Xilinx_FGG484
U15: AMJMEFB-100.0000T; AMJMEFB
U17, U18: USB3300-EZK-TR; QFN50P500X500X100-33N
U20: KSZ9031RNXCA; QFN-48-Microchip-QFN77-48LD-PL-2
Y1, Y3: TSX-3225; KX-7
Y2: ABM8G-25.000MHZ-18-D2Y-T; KX-7

Connections:
3V0_BAT: J5.B41, J12.1
/DDR3/DDR3_VTT: C40.1, C41.1, C43.1, R54.2, R55.2, R56.2, R162.2, R163.2, R164.2, R167.2, R168.2, R169.2, R170.2, R171.2, R172.2, R173.2, R174.2, R175.2, R176.2, R177.2, R178.2, R179.2, R180.2, R181.2, R182.2, R183.2, R184.2, U8.3, U8.5
/Ethernet/AVDDH: C206.1, C211.1, C215.1, FB4.2, U20.1, U20.12
/Ethernet/AVDDL: C200.1, C204.1, C209.1, C213.1, FB6.1, U20.4, U20.9
/Ethernet/AVDDL_PLL: C199.1, C203.1, C208.1, FB5.1, U20.44
/Ethernet/ETH1_N: J1.10, U20.3
/Ethernet/ETH1_P: J1.11, U20.2
/Ethernet/ETH2_N: J1.5, U20.6
/Ethernet/ETH2_P: J1.4, U20.5
/Ethernet/ETH3_N: J1.2, U20.8
/Ethernet/ETH3_P: J1.3, U20.7
/Ethernet/ETH4_N: J1.9, U20.11
/Ethernet/ETH4_P: J1.8, U20.10
/Ethernet/ETH_LED1: R157.1, U20.15
/Ethernet/ETH_LED2: R158.1, U20.17
/Interfaces/1V0_EN: C39.2, R53.2, U6.2, U6.20
/Interfaces/PCIE_BMC_TX_C_N: C194.1, U14.A4
/Interfaces/PCIE_BMC_TX_C_P: C195.1, U14.B4
/PCIe-connector/NVME_LED: D1.2, J2.10
/PCIe-connector/PCIE_HPM_TX0_C_N: C29.1, J2.47
/PCIe-connector/PCIE_HPM_TX0_C_P: C27.1, J2.49
/PCIe-connector/PCIE_HPM_TX1_C_N: C30.1, J2.35
/PCIe-connector/PCIE_HPM_TX1_C_P: C28.1, J2.37
/PCIe-connector/PCIE_HPM_TX2_C_N: C181.1, J2.23
/PCIe-connector/PCIE_HPM_TX2_C_P: C179.1, J2.25
/PCIe-connector/PCIE_HPM_TX3_C_N: C182.1, J2.11
/PCIe-connector/PCIE_HPM_TX3_C_P: C180.1, J2.13
/Power supply/1V0_PG: Q7.1, R61.2, U12.8
/Power supply/1V8_PG: Q9.1, R91.2, U11.8
/Power supply/1V35_PG: Q10.1, R92.2, U13.8
/Power supply/2V5_PG: Q11.1, R93.2
/Power supply/PWR_EN: Q8.1, R62.2, U9.2
/Power supply/VCCAUX_EN: R15.2, R64.2, U9.7
/Power supply/VCCINT_EN: R16.2, R63.2, U9.8
/Power supply/VCCIO_EN: R14.2, R65.2, R138.2, U9.6
CHASI#: J5.A54, R110.2
CHASI#_R: R110.1, U14.Y3
DBP_PRDY_N: J5.A50, R106.2
DBP_PRDY_N_R: R106.1, U14.W2
DBP_PREQ_N: J5.A49, R105.2
DBP_PREQ_N_R: R105.1, U14.V2
DDR3_A0: R168.1, U7.N3, U14.M2
DDR3_A1: R175.1, U7.P7, U14.M5
DDR3_A2: R169.1, U7.P3, U14.M3
DDR3_A3: R167.1, U7.N2, U14.M1
DDR3_A4: R178.1, U7.P8, U14.L6
DDR3_A5: R172.1, U7.P2, U14.P1
DDR3_A6: R179.1, U7.R8, U14.N3
DDR3_A7: R170.1, U7.R2, U14.N2
DDR3_A8: R180.1, U7.T8, U14.M6
DDR3_A9: R171.1, U7.R3, U14.R1
DDR3_A10: R183.1, U7.L7, U14.L5
DDR3_A11: R176.1, U7.R7, U14.N5
DDR3_A12: R174.1, U7.N7, U14.N4
DDR3_A13: R173.1, U7.T3, U14.P2
DDR3_A14: R177.1, U7.T7, U14.P6
DDR3_BA0: R163.1, U7.M2, U14.L3
DDR3_BA1: R181.1, U7.N8, U14.K6
DDR3_BA2: R164.1, U7.M3, U14.L4
DDR3_CAS: R55.1, U7.K3, U14.K3
DDR3_CKE: R182.1, U7.K9, U14.J6
DDR3_CLK_N: R100.2, U7.K7, U14.P4
DDR3_CLK_P: R99.2, U7.J7, U14.P5
DDR3_CS: R184.1, U7.L2
DDR3_DM0: U7.E7, U14.G3
DDR3_DM1: U7.D3, U14.F1
DDR3_DQ0: U7.E3, U14.G2
DDR3_DQ1: U7.F7, U14.H4
DDR3_DQ2: U7.F2, U14.H5
DDR3_DQ3: U7.F8, U14.J1
DDR3_DQ4: U7.H3, U14.K1
DDR3_DQ5: U7.H8, U14.H3
DDR3_DQ6: U7.G2, U14.H2
DDR3_DQ7: U7.H7, U14.J5
DDR3_DQ8: U7.D7, U14.E3
DDR3_DQ9: U7.C3, U14.B2
DDR3_DQ10: U7.C8, U14.F3
DDR3_DQ11: U7.C2, U14.D2
DDR3_DQ12: U7.A7, U14.C2
DDR3_DQ13: U7.A2, U14.A1
DDR3_DQ14: U7.B8, U14.E2
DDR3_DQ15: U7.A3, U14.B1
DDR3_DQS0_N: U7.G3, U14.J2
DDR3_DQS0_P: U7.F3, U14.K2
DDR3_DQS1_N: U7.B7, U14.D1
DDR3_DQS1_P: U7.C7, U14.E1
DDR3_ODT: R56.1, U7.K1, U14.K4
DDR3_RAS: R54.1, U7.J3, U14.J4
DDR3_RESET: R13.1, U7.T2, U14.G1
DDR3_VREF: C42.1, C44.1, C57.1, C62.1, U7.H1, U7.M8, U8.6
DDR3_WE: R162.1, U7.L3, U14.L1
DONE: Q13.1, R88.2, TP2.1, U14.G11
ESPI_ALERT_N: J5.B3, U14.H18
ESPI_CLK: J5.B1, U14.L18
ESPI_CS0_N: J5.B2, U14.K18
ESPI_CS1_N: J5.B9, U14.G15
ESPI_IO0: J5.B5, U14.K17
ESPI_IO1: J5.B6, U14.M16
ESPI_IO2: J5.B7, U14.K16
ESPI_IO3: J5.B8, U14.L16
ESPI_RESET_N: J5.B4, U14.M17
ETH_INT_N: U14.N20, U20.38
ETH_MDC: R154.1, U14.N22, U20.36
ETH_MDIO: R155.1, U14.M20, U20.37
ETH_~RESET: R156.1, U14.N18, U20.42
GCLK100: U14.C18, U15.3
GND: C1.2, C2.2, C3.2, C4.2, C5.2, C6.2, C7.2, C8.2, C9.2, C10.2, C11.2, C12.2, C13.2, C14.2, C15.2, C16.2, C17.2, C18.2, C19.2, C20.2, C21.2, C22.2, C23.2, C24.2, C25.2, C26.2, C31.2, C32.2, C33.2, C34.2, C35.2, C36.2, C37.2, C38.2, C39.1, C40.2, C41.2, C42.2, C43.2, C44.2, C45.2, C46.2, C47.2, C48.2, C49.2, C50.2, C51.2, C52.2, C53.2, C54.2, C55.2, C56.2, C57.2, C58.2, C59.2, C60.2, C61.2, C62.2, C63.1, C64.2, C65.2, C66.2, C67.2, C68.2, C69.2, C70.2, C72.2, C73.2, C74.2, C75.2, C76.2, C77.2, C78.2, C83.2, C84.2, C85.2, C86.2, C87.2, C88.2, C89.2, C90.2, C91.2, C92.2, C93.2, C94.2, C95.2, C96.2, C97.2, C98.2, C99.2, C100.2, C101.2, C102.2, C103.2, C104.2, C105.2, C106.2, C107.2, C108.2, C109.2, C110.2, C111.2, C112.2, C113.2, C114.2, C115.2, C116.2, C117.2, C118.2, C119.2, C120.2, C121.2, C122.2, C123.2, C124.2, C125.2, C126.2, C127.2, C128.2, C129.2, C130.2, C131.2, C132.2, C133.2, C134.2, C135.2, C136.2, C137.2, C138.2, C139.2, C140.2, C141.2, C142.2, C143.2, C144.2, C145.2, C146.2, C147.2, C148.2, C150.2, C152.2, C153.2, C154.2, C156.2, C157.2, C158.2, C159.2, C160.2, C161.2, C162.2, C163.2, C164.2, C165.2, C166.2, C167.2, C168.2, C170.2, C171.2, C172.2, C174.2, C175.2, C176.2, C178.2, C183.2, C184.2, C185.2, C186.2, C187.2, C188.2, C189.2, C190.2, C191.2, C192.2, C193.2, C196.2, C197.2, C198.2, C199.2, C200.2, C201.2, C202.2, C203.2, C204.2, C205.2, C206.2, C207.2, C208.2, C209.2, C210.2, C211.2, C212.2, C213.2, C214.2, C215.2, C216.2, C217.2, C218.2, C219.2, C220.2, C221.2, C222.2, C223.2, C224.2, C225.2, C226.2, C227.2, C228.2, C229.2, C230.2, C231.2, C232.2, C233.2, C234.2, C235.2, C236.2, C237.2, C238.2, C239.2, C240.2, C241.2, C242.2, C243.2, C244.2, D2.5, D2.10, D3.A, IC1.8, IC1.11, IC2.2, J1.13, J1.15, J1.S1, J1.S2, J2.1, J2.3, J2.9, J2.15, J2.21, J2.27, J2.33, J2.39, J2.45, J2.51, J2.57, J2.71, J2.73, J2.75, J2.SH1, J2.SH2, J3.1, J4.5, J4.11, J5.A11, J5.A14, J5.A17, J5.A20, J5.A33, J5.A42, J5.A58, J5.A61, J5.A64, J5.A67, J5.A70, J5.B10, J5.B17, J5.B26, J5.B33, J5.B38, J5.B49, J5.B52, J5.B55, J5.B58, J5.B61, J5.B64, J5.B67, J5.B70, J5.OA3, J5.OA4, J5.OA13, J5.OB4, J5.OB7, J5.OB10, J6.1, J6.3, J6.5, J6.7, J6.9, J6.11, J6.13, J7.6, J12.2, J13.3, PROG_B1.2, Q7.2, Q8.2, Q9.2, Q10.2, Q11.2, Q12.2, Q13.2, Q14.2, Q15.2, Q16.2, R2.2, R5.1, R7.1, R13.2, R57.1, R60.2, R67.1, R72.2, R74.2, R76.2, R78.2, R80.2, R82.1, R84.1, R87.2, R159.1, TP4.1, U1.G2, U1.G3, U1.G4, U1.G5, U1.G6, U1.G7, U1.G8, U1.G9, U1.J5, U2.4, U3.4, U4.4, U5.4, U6.1, U7.A9, U7.B1, U7.B3, U7.B9, U7.D1, U7.D8, U7.E1, U7.E2, U7.E8, U7.F9, U7.G1, U7.G8, U7.G9, U7.J2, U7.J8, U7.M1, U7.M9, U7.P1, U7.P9, U7.T1, U7.T9, U8.4, U8.8, U8.11, U9.3, U10.3, U10.5, U11.3, U11.5, U12.3, U12.5, U13.3, U13.5, U14.A2, U14.A3, U14.A5, U14.A7, U14.A9, U14.A11, U14.A12, U14.A22, U14.AA2, U14.AA12, U14.AA22, U14.AB9, U14.AB19, U14.B3, U14.B12, U14.B19, U14.C3, U14.C6, U14.C10, U14.C12, U14.C16, U14.D3, U14.D4, U14.D8, U14.D12, U14.D13, U14.E4, U14.E5, U14.E7, U14.E9, U14.E11, U14.E20, U14.F5, U14.F11, U14.F17, U14.G5, U14.G6, U14.G7, U14.G8, U14.G9, U14.G10, U14.G12, U14.G14, U14.H1, U14.H7, U14.H9, U14.H11, U14.H21, U14.J8, U14.J10, U14.J12, U14.J18, U14.K5, U14.K7, U14.K9, U14.K11, U14.K15, U14.L2, U14.L8, U14.L9, U14.L10, U14.L22, U14.M7, U14.M9, U14.M10, U14.M11, U14.M19, U14.N6, U14.N8, U14.N9, U14.N10, U14.N16, U14.P3, U14.P7, U14.P9, U14.P11, U14.P13, U14.R8, U14.R10, U14.R12, U14.R20, U14.T7, U14.T9, U14.T11, U14.T17, U14.U4, U14.U14, U14.V1, U14.V11, U14.V21, U14.W8, U14.W18, U14.Y5, U14.Y15, U15.2, U17.1, U17.2, U17.33, U18.1, U18.2, U18.33, U20.29, U20.49, Y1.2, Y1.4, Y2.2, Y2.4, Y3.2, Y3.4
HPM_FW_RECOVERY: J5.A43, R101.2
HPM_FW_RECOVERY_R: R101.1, U14.U3
HPM_STBY_RST_N: J5.A46, R102.2
HPM_STBY_RST_N_R: R102.1, U14.U1
I2C[0]_SCL: J5.A1, U14.J16
I2C[0]_SDA: J5.A2, U14.J15
I2C[1]_SCL: J5.A3, U14.L15
I2C[1]_SDA: J5.A4, U14.M15
I2C[2]_SCL: J5.A5, U14.L14
I2C[2]_SDA: J5.A6, U14.J14
I2C[3]_SCL: J5.A7, U14.K14
I2C[3]_SDA: J5.A8, U14.M13
I2C[4]_SCL: J5.A9, U14.K13
I2C[4]_SDA: J5.A10, U14.L13
I2C[5]_SCL: J5.A21, U14.N13
I2C[5]_SDA: J5.A22, U14.N14
I2C[6]_SCL: J5.A23, U14.H13
I2C[6]_SDA: J5.A24, U14.G13
I2C[7]_SCL: J5.A25, U14.F13
I2C[7]_SDA: J5.A26, U14.E13
I2C[8]_SCL: J5.A27, U14.C13
I2C[8]_SDA: J5.A28, U14.C14
I2C[9]_SCL: J5.A29, U14.T5
I2C[9]_SDA: J5.A30, U14.T6
I2C[10]_SCL: J5.A31, U14.U6
I2C[10]_SDA: J5.A32, U14.W6
I2C[11]_SCL: J5.A38, U14.W7
I2C[11]_SDA: J5.A39, U14.W9
I2C[12]_SCL: J5.A40, U14.V8
I2C[12]_SDA: J5.A41, U14.V9
I3C[0]_SCL: J5.OA5, U6.18
I3C[0]_SCL_3V3: R46.2, U6.3, U14.A21
I3C[0]_SDA: J5.OA6, U6.17
I3C[0]_SDA_3V3: R45.2, U6.4, U14.B20
I3C[1]_SCL: J5.OA7, U6.16
I3C[1]_SCL_3V3: R48.2, U6.5, U14.D20
I3C[1]_SDA: J5.OA8, U6.15
I3C[1]_SDA_3V3: R47.2, U6.6, U14.F20
I3C[2]_SCL: J5.OA9, U6.14
I3C[2]_SCL_3V3: R50.2, U6.7, U14.C19
I3C[2]_SDA: J5.OA10, U6.13
I3C[2]_SDA_3V3: R49.2, U6.8, U14.F19
I3C[3]_SCL: J5.OA11, U6.12
I3C[3]_SCL_3V3: R52.2, U6.9, U14.D19
I3C[3]_SDA: J5.OA12, U6.11
I3C[3]_SDA_3V3: R51.2, U6.10, U14.F18
INIT: J3.19, Q12.1, R90.2, TP5.1, U14.U12
IRQ_N: J5.A56, R112.2
IRQ_N_R: R112.1, U14.AB1
JTAG_TCK: D2.13, J5.A34, J6.6, U14.V12
JTAG_TDI: D2.8, J5.A36, J6.10, U14.R13
JTAG_TDO: D2.9, J5.A37, J6.8, U14.U13
JTAG_TMS: D2.14, J5.A35, J6.4, U14.T13
MMC_CLK: R116.2, U1.P6, U14.Y18
MMC_CMD: R118.2, U1.P5, U14.Y19
MMC_DAT0: R119.2, U1.K2, U14.P17
MMC_DAT1: R120.2, U1.N2, U14.W17
MMC_DAT2: R121.2, U1.K3, U14.R18
MMC_DAT3: R122.2, U1.N3, U14.V18
MMC_DAT4: R123.2, U1.N8, U14.U18
MMC_DAT5: R124.2, U1.K8, U14.U17
MMC_DAT6: R125.2, U1.N9, U14.T18
MMC_DAT7: R126.2, U1.K9, U14.R17
MMC_RSTN: R117.2, U1.M5, U14.V19
MODE0: R81.2, R82.2, U14.U11
MODE1: R83.2, R84.2, U14.U10
MODE2: J13.2, U14.U9
NCSI_CLK: J5.B18, U14.B13
NCSI_CRS_DV: J5.B19, U14.A14
NCSI_RXD0: J5.B24, U14.A15
NCSI_RXD1: J5.B25, U14.B15
NCSI_RXER: J5.B23, U14.C15
NCSI_TXD0: J5.B21, U14.D14
NCSI_TXD1: J5.B22, U14.E14
NCSI_TXEN: J5.B20, U14.A13
unnamed: C1.1, R57.2, R58.2, U8.1
unnamed: C4.1, R3.1, U17.27, Y1.1
unnamed: C5.1, R4.1, U18.27, Y3.1
unnamed: C6.1, R3.2, U17.28, Y1.3
unnamed: C7.1, R4.2, U18.28, Y3.3
unnamed: C20.1, R9.2, U17.15, U17.26
unnamed: C22.1, U18.29
unnamed: C25.1, U17.29
unnamed: C26.1, R12.2, U18.15, U18.26
unnamed: C63.2, R99.1, R100.1
unnamed: C64.1, U9.5
unnamed: C68.1, R66.2
unnamed: C69.1, IC1.4
unnamed: C70.1, IC1.7, R66.1
unnamed: C71.1, D3.C, IC1.9, L1.1
unnamed: C71.2, IC1.1
unnamed: C72.1, C73.1, C74.1, L1.2, R69.2, R70.1
unnamed: C79.1, C83.1, C87.1, L2.2, R73.1, R139.2, TP8.1
unnamed: C79.2, R73.2, R74.1, U10.2
unnamed: C80.1, C84.1, C88.1, L3.2, R75.1, R140.2, TP9.1
unnamed: C80.2, R75.2, R76.1, U11.2
unnamed: C81.1, C85.1, C89.1, L4.2, R77.1, R141.2, TP10.1
unnamed: C81.2, R77.2, R78.1, U12.2
unnamed: C82.1, C86.1, C90.1, L5.2, R79.1, R142.2, TP11.1
unnamed: C82.2, R79.2, R80.1, U13.2
unnamed: C188.1, C189.1, U1.E4
unnamed: C220.1, R160.1, U20.45, Y2.1
unnamed: C221.1, R160.2, U20.46, Y2.3
unnamed: C225.1, J1.12
unnamed: C226.1, J1.6
unnamed: C227.1, J1.1
unnamed: C228.1, J1.7
unnamed: D1.1, R18.2
unnamed: D4.1, R94.1
unnamed: D4.2, Q7.3
unnamed: D5.1, R95.1
unnamed: D5.2, Q8.3
unnamed: D6.1, R96.1
unnamed: D6.2, Q9.3
unnamed: D7.1, R97.1
unnamed: D7.2, Q10.3
unnamed: D8.1, R98.1
unnamed: D8.2, Q11.3
unnamed: D9.1, R128.1
unnamed: D9.2, Q12.3
unnamed: D10.1, R129.1
unnamed: D10.2, Q13.3
unnamed: D11.1, R130.1
unnamed: D11.2, Q14.3
unnamed: D12.1, R131.1
unnamed: D12.2, Q15.3
unnamed: D13.1, R132.1
unnamed: D13.2, Q16.3
unnamed: IC1.3, TP1.1
unnamed: IC1.5, R67.2
unnamed: IC1.6, R71.2, R72.1
unnamed: J1.14, R165.1
unnamed: J1.16, R166.1
unnamed: J2.44, R20.2
unnamed: J2.52, R17.2, TP13.1
unnamed: J2.54, TP12.1
unnamed: J5.B35, R136.1
unnamed: L2.1, U10.6
unnamed: L3.1, U11.6
unnamed: L4.1, U12.6
unnamed: L5.1, U13.6
unnamed: R5.2, U17.32
unnamed: R6.2, U17.4
unnamed: R7.2, U18.32
unnamed: R8.2, U18.4
unnamed: R10.1, U17.31
unnamed: R11.1, U18.31
unnamed: R14.1, U10.1
unnamed: R15.1, U11.1
unnamed: R16.1, U12.1
unnamed: R59.2, U8.9
unnamed: R60.1, U7.L8
unnamed: R70.2, R71.1
unnamed: R85.2, U14.U8
unnamed: R133.2, R161.1, U14.T19
unnamed: R138.1, U13.1
unnamed: R143.2, U14.F8
unnamed: R159.2, U20.48
unnamed: U1.H2, U1.H9, U1.L3, U1.L8, U1.M4, U1.M7, U1.P2, U1.P9
P12V_AUX: F1.1, J5.OA1, J5.OA2, J5.OB1, J5.OB2
PCIE_BMC_CLK_100_N: J5.A13, U14.E6
PCIE_BMC_CLK_100_P: J5.A12, U14.F6
PCIE_BMC_RX_N: J5.A19, U14.A8
PCIE_BMC_RX_P: J5.A18, U14.B8
PCIE_BMC_TX_N: C194.2, J5.A16
PCIE_BMC_TX_P: C195.2, J5.A15
PCIE_HPM_CLK_N: J2.53, J5.B57
PCIE_HPM_CLK_P: J2.55, J5.B56
PCIE_HPM_RX[0]_N: J2.41, J5.A60
PCIE_HPM_RX[0]_P: J2.43, J5.A59
PCIE_HPM_RX[1]_N: J2.29, J5.A63
PCIE_HPM_RX[1]_P: J2.31, J5.A62
PCIE_HPM_RX[2]_N: J2.17, J5.A66
PCIE_HPM_RX[2]_P: J2.19, J5.A65
PCIE_HPM_RX[3]_N: J2.5, J5.A69
PCIE_HPM_RX[3]_P: J2.7, J5.A68
PCIE_HPM_TX[0]_N: C29.2, J5.B60
PCIE_HPM_TX[0]_P: C27.2, J5.B59
PCIE_HPM_TX[1]_N: C30.2, J5.B63
PCIE_HPM_TX[1]_P: C28.2, J5.B62
PCIE_HPM_TX[2]_N: C181.2, J5.B66
PCIE_HPM_TX[2]_P: C179.2, J5.B65
PCIE_HPM_TX[3]_N: C182.2, J5.B69
PCIE_HPM_TX[3]_P: C180.2, J5.B68
PROGRAM: J3.18, PROG_B1.1, PROG_B1.3, R89.2, TP6.1, U14.N12
PRSNT0_N: J5.OB3, R114.2
PRSNT0_N_R: R114.1, U14.E21
PRSNT1_N: J2.50, J5.A57, R19.2, TP14.1
PUDC_B: R1.2, R2.1, U14.U22
PWR_GOOD: IC1.10, R68.2
QSPI0_CLK: J3.7, J5.B11
QSPI0_CS0_N: J3.8, J5.B12
QSPI0_CS1_N: J3.22, J5.B42
QSPI0_D0: J3.9, J5.B13
QSPI0_D1: J3.10, J5.B14
QSPI0_D2: J3.11, J5.B15
QSPI0_D3: J3.12, J5.B16
QSPI1_CLK: J5.B43, U14.R4
QSPI1_CS0_N: J5.B44, U14.R2
QSPI1_D0: J5.B45, U14.R3
QSPI1_D1: J5.B46, U14.T4
QSPI1_D2: J5.B47, U14.T3
QSPI1_D3: J5.B48, U14.T1
QSPIA1_CS_N: J3.4, R24.2, U5.1
QSPIA1_D0: J3.6, R32.1, U5.5
QSPIA1_D1: J3.3, R44.1, U5.2
QSPIA1_D2: J3.2, R36.1, U5.3
QSPIA1_D3: J3.5, R40.1, U5.7
QSPIA2_CS_N: J3.25, R23.2, U4.1
QSPIA2_D0: J3.28, R31.1, U4.5
QSPIA2_D1: J3.24, R43.1, U4.2
QSPIA2_D2: J3.23, R35.1, U4.3
QSPIA2_D3: J3.26, R39.1, U4.7
QSPIA_CLK: J3.27, R27.2, R28.2, U4.6, U5.6
QSPIB1_CS_N: J3.31, R22.2, U3.1
QSPIB1_D0: J3.33, R30.1, U3.5
QSPIB1_D1: J3.30, R42.1, U3.2
QSPIB1_D2: J3.29, R34.1, U3.3
QSPIB1_D3: J3.32, R38.1, U3.7
QSPIB2_CS_N: J3.36, R21.2, U2.1
QSPIB2_D0: J3.39, R29.1, U2.5
QSPIB2_D1: J3.35, R41.1, U2.2
QSPIB2_D2: J3.34, R33.1, U2.3
QSPIB2_D3: J3.37, R37.1, U2.7
QSPIB_CLK: J3.38, R25.2, R26.2, U2.6, U3.6
RGMII_REF_CLK: R153.1, U14.N19, U20.41
RGMII_RXD0: R127.1, U14.L20, U20.32
RGMII_RXD1: R148.1, U14.L21, U20.31
RGMII_RXD2: R149.1, U14.K21, U20.28
RGMII_RXD3: R150.1, U14.K22, U20.27
RGMII_RX_CLK: R152.1, U14.M21, U20.35
RGMII_RX_DV: R151.1, U14.M22, U20.33
RGMII_TXD0: U14.G20, U20.19
RGMII_TXD1: U14.H20, U20.20
RGMII_TXD2: U14.H22, U20.21
RGMII_TXD3: U14.J21, U20.22
RGMII_TX_CLK: U14.J22, U20.24
RGMII_TX_DV: U14.J20, U20.25
ROT_QSPI_CS_B: J3.40, R161.2
ROT_QSPI_DQ0: J3.17, U14.P22
ROT_QSPI_DQ1: J3.16, U14.R22
ROT_QSPI_DQ2: J3.15, R134.2, U14.P21
ROT_QSPI_DQ3: J3.14, R135.2, U14.R21
ROT_QSPI_SCK: J3.13, R86.2, R87.1, U14.L12
RST_PLTRST_BUF_N: J5.A51, R107.2
RST_PLTRST_BUF_N_R: R107.1, U14.W1
RSVD2: R136.2, R137.1, U14.Y7
RoT_CPU_RST_N: J5.A53, R109.2
RoT_CPU_RST_N_R: R109.1, U14.Y1
SGPIO0_CLK: J5.B30, R137.2, U14.W5
SGPIO0_DI: J5.B31, U14.W4
SGPIO0_DO: J5.B29, U14.V5
SGPIO0_LD: J5.B32, U14.V7
SGPIO1_DI: J5.B36, U14.Y8
SGPIO1_DO: J5.B34, U14.Y6
SGPIO1_LD: J5.B37, U14.Y9
SGPIO_INTR_N: J5.B40, U14.U7
SGPIO_RESET_N: J5.B39, U14.U5
SPARE0: J5.A55, R111.2
SPARE0_R: R111.1, U14.AA1
SPARE1: J5.A52, R108.2
SPARE1_R: R108.1, U14.Y2
SPI0_CLK: J4.4, J5.OB11, J7.4, R145.2
SPI0_CLK_R: R145.1, U14.E16
SPI0_CS_N: J4.1, J5.OB12, J7.5, R146.2
SPI0_CS_N_R: R146.1, U14.D16
SPI0_MISO: J4.3, J5.OB14, J7.3, R147.2
SPI0_MISO_R: R147.1, U14.B16
SPI0_MOSI: J4.2, J5.OB13, J7.2, R144.2
SPI0_MOSI_R: R144.1, U14.A16
SYS_PWRBTN_N: J5.A47, R103.2
SYS_PWRBTN_N_R: R103.1, U14.U2
SYS_PWROK: J5.A48, R104.2
SYS_PWROK_R: R104.1, U14.V3
UART0_SCM_RX: J5.OB9, U14.D17
UART0_SCM_TX: J5.OB8, U14.E17
UART1_SCM_RX: J5.OB6, U14.T21
UART1_SCM_TX: J5.OB5, U14.U21
ULPI1_CLKOUT: U14.W19, U17.14
ULPI1_DATA0: U14.AB18, U17.24
ULPI1_DATA1: U14.AA18, U17.23
ULPI1_DATA2: U14.AA19, U17.22
ULPI1_DATA3: U14.AB20, U17.21
ULPI1_DATA4: U14.AA20, U17.20
ULPI1_DATA5: U14.AB21, U17.19
ULPI1_DATA6: U14.AA21, U17.18
ULPI1_DATA7: U14.AB22, U17.17
ULPI1_DIR: U14.W21, U17.12
ULPI1_NXT: U14.W22, U17.11
ULPI1_RESET: U14.V20, U17.9
ULPI1_STP: U14.Y22, U17.13
ULPI2_CLKOUT: U14.V4, U18.14
ULPI2_DATA0: U14.AB2, U18.24
ULPI2_DATA1: U14.AA3, U18.23
ULPI2_DATA2: U14.AB3, U18.22
ULPI2_DATA3: U14.Y4, U18.21
ULPI2_DATA4: U14.AA4, U18.20
ULPI2_DATA5: U14.AB5, U18.19
ULPI2_DATA6: U14.AA5, U18.18
ULPI2_DATA7: U14.AB6, U18.17
ULPI2_DIR: U14.AB7, U18.12
ULPI2_NXT: U14.AB8, U18.11
ULPI2_RESET: U14.AA8, U18.9
ULPI2_STP: U14.AA6, U18.13
USB1_D_N: J5.B54, U17.8
USB1_D_P: J5.B53, U17.7
USB2_D_N: J5.B51, U18.8
USB2_D_P: J5.B50, U18.7
USR_LED0: Q14.1, U14.T20
USR_LED1: Q15.1, U14.U20
USR_LED2: Q16.1, U14.W20
VCC1V0: C134.1, C136.1, C138.1, C140.1, C142.1, C145.1, C147.1, C150.1, C152.1, C153.1, C154.1, C156.1, C157.1, C158.1, C159.1, C160.1, C161.1, C162.1, C163.1, C164.1, C165.1, C166.1, C167.1, C168.1, C170.1, C171.1, C172.1, C174.1, C175.1, C176.1, C190.1, R141.1, U6.19, U14.D6, U14.D10, U14.E8, U14.F7, U14.F9, U14.H8, U14.H10, U14.J7, U14.J9, U14.J11, U14.K8, U14.L7, U14.L11, U14.M8, U14.N7, U14.N11, U14.P8, U14.P10, U14.R7, U14.R9, U14.T8, U14.T10
VCC1V2: C3.1, C191.1, C192.1, C193.1, C196.1, C197.1, C201.1, C205.1, C210.1, C214.1, C217.1, C218.1, C219.1, C241.1, FB5.2, FB6.2, IC2.5, R143.1, U14.B5, U14.B7, U14.B9, U14.B11, U14.C4, U14.C8, U20.14, U20.23, U20.26, U20.30, U20.39
VCC1V8: C133.1, C135.1, C137.1, C139.1, C141.1, C143.1, C144.1, C146.1, C148.1, C242.1, R9.1, R12.1, R20.1, R140.1, U14.E12, U14.H12, U14.K10, U14.K12, U14.M12, U14.P12, U14.R11
VCC1V35: C8.1, C9.1, C45.1, C46.1, C48.1, C49.1, C50.1, C51.1, C52.1, C53.1, C54.1, C55.1, C56.1, C58.1, C59.1, C60.1, C61.1, C96.1, C102.1, C108.1, C114.1, C120.1, C126.1, C132.1, C243.1, C244.1, R58.1, R142.1, U7.A1, U7.A8, U7.B2, U7.C1, U7.C9, U7.D2, U7.D9, U7.E9, U7.F1, U7.G7, U7.H2, U7.H9, U7.K2, U7.K8, U7.N1, U7.N9, U7.R1, U7.R9, U8.2, U14.C1, U14.F2, U14.H6, U14.J3, U14.M4, U14.N1
VCC3V3: C2.1, C10.1, C11.1, C12.1, C13.1, C18.1, C19.1, C21.1, C23.1, C24.1, C31.1, C32.1, C33.1, C34.1, C35.1, C36.1, C37.1, C38.1, C47.1, C91.1, C92.1, C93.1, C94.1, C95.1, C97.1, C98.1, C99.1, C100.1, C101.1, C103.1, C104.1, C105.1, C106.1, C107.1, C109.1, C110.1, C111.1, C112.1, C113.1, C115.1, C116.1, C117.1, C118.1, C119.1, C121.1, C122.1, C123.1, C124.1, C125.1, C127.1, C128.1, C129.1, C130.1, C131.1, C178.1, C183.1, C184.1, C185.1, C186.1, C187.1, C198.1, C202.1, C207.1, C212.1, C216.1, C222.1, C223.1, C224.1, C229.1, C230.1, C231.1, C232.1, C233.1, C234.1, C235.1, C236.1, C237.1, C238.1, C239.1, C240.1, FB4.1, IC2.1, IC2.3, J2.2, J2.4, J2.12, J2.14, J2.16, J2.18, J2.70, J2.72, J2.74, J3.21, J4.6, J4.12, J6.2, J7.1, J13.1, R1.1, R10.2, R11.2, R17.1, R18.1, R19.1, R21.1, R22.1, R23.1, R24.1, R25.1, R26.1, R27.1, R28.1, R29.2, R30.2, R31.2, R32.2, R33.2, R34.2, R35.2, R36.2, R37.2, R38.2, R39.2, R40.2, R41.2, R42.2, R43.2, R44.2, R45.1, R46.1, R47.1, R48.1, R49.1, R50.1, R51.1, R52.1, R53.1, R59.1, R81.1, R83.1, R85.1, R86.1, R88.1, R89.1, R90.1, R94.2, R95.2, R96.2, R97.2, R98.2, R116.1, R117.1, R118.1, R119.1, R120.1, R121.1, R122.1, R123.1, R124.1, R125.1, R126.1, R127.2, R128.2, R129.2, R130.2, R131.2, R132.2, R133.1, R134.1, R135.1, R139.1, R148.2, R149.2, R150.2, R151.2, R152.2, R153.2, R154.2, R155.2, R156.2, R157.2, R158.2, U1.F2, U1.F3, U1.F4, U1.F5, U1.F6, U1.F7, U1.F8, U1.F9, U1.H3, U1.H8, U1.L2, U1.L4, U1.L7, U1.L9, U1.P3, U1.P8, U2.8, U3.8, U4.8, U5.8, U8.7, U8.10, U14.A17, U14.AA7, U14.AA17, U14.AB4, U14.AB14, U14.B14, U14.C21, U14.D18, U14.E15, U14.F12, U14.F22, U14.G19, U14.H16, U14.J13, U14.K20, U14.L17, U14.M14, U14.N21, U14.P18, U14.R5, U14.R15, U14.T2, U14.T12, U14.T22, U14.U19, U14.V6, U14.V16, U14.W3, U14.W13, U14.Y10, U14.Y20, U15.1, U15.4, U17.6, U17.16, U17.25, U17.30, U18.6, U18.16, U18.25, U18.30, U20.16, U20.34, U20.40
VCC5V0: C75.1, C76.1, C77.1, C78.1, R6.1, R8.1, R61.1, R62.1, R63.1, R64.1, R65.1, R68.1, R69.1, R91.1, R92.1, R93.1, TP7.1, U9.1, U9.4, U10.7, U11.7, U12.7, U13.7
VCC12V: C14.1, C15.1, C16.1, C17.1, C65.1, C66.1, C67.1, F1.2, IC1.2, TP3.1
VIRTUAL_RESEAT: J5.OA14, R115.2
VIRTUAL_RESEAT_R: R115.1, U14.E22
