antmicro/artix-dc-scm/(commit log)

2020-12-11 Initial commit - moved interfaces from ECP5, replaced FPGA, done FPGA decoupling
    [artix-dc-scm.kicad_pcb, artix-dc-scm.sch, ddr3.sch, edge-connector.sch, ethernet.sch, fpga-banks.sch, fpga-power-supply.sch, interfaces.sch]
2020-12-11 Changes to voltage regulators
    [power-supply.sch]
2020-12-11 DDR3 sheet edits
    [ddr3.sch]
2020-12-11 Minor changes to FPGA
    [fpga-banks.sch, fpga-power-supply.sch]
2020-12-11 Added Xilinx JTAG connector
    [interfaces.sch]
2020-12-11 Added FPGA connections
    [fpga-banks.sch]
2020-12-11 FPGA supplies update
    [fpga-power-supply.sch]
2020-12-12 Updated power sequencer
    [fpga-banks.sch, fpga-power-supply.sch, power-supply.sch]
2020-12-12 Added TPM SPI connector
    [rot.sch]
2020-12-12 Removed redundant VRs (2V5, 1V2)
    [power-supply.sch]
2020-12-12 Initial component placement added (to be adjusted further)
    [artix-dc-scm.kicad_pcb, ddr3.sch, edge-connector.sch, ethernet.sch, fpga-banks.sch, fpga-power-supply.sch, interfaces.sch, pcie-conn.sch]
2020-12-13 Removed inverters
    [power-supply.sch]
2020-12-13 Minor fixes in component placement
    [artix-dc-scm.kicad_pcb, fpga-banks.sch]
2020-12-13 Neatened main sheet
    [artix-dc-scm.sch, power-supply.sch]
2020-12-14 Update after designator unification
    [artix-dc-scm.kicad_pcb, artix-dc-scm.sch, ddr3.sch, edge-connector.sch, ethernet.sch, fpga-banks.sch, fpga-power-supply.sch, interfaces.sch]
2020-12-14 Ethernet IC component placement done
    [artix-dc-scm.kicad_pcb]
2020-12-14 DDR3 PMIC initial placement done
    [artix-dc-scm.kicad_pcb]
2020-12-14 5V0 VR component placement done
    [artix-dc-scm.kicad_pcb]
2020-12-14 Fix outline
    [artix-dc-scm.kicad_pcb]
2020-12-14 Close PCB outline
    [artix-dc-scm.kicad_pcb]
2020-12-15 Added block diagram
    [artix-dc-scm.sch]
2020-12-15 Added DDR3 and FLASH layout
    [artix-dc-scm.kicad_pcb]
2020-12-15 Updated board 3D models
    [SSD.STEP, artix-dc-scm.kicad_pcb]
2020-12-15 Added M.2 connector layout
    [artix-dc-scm.kicad_pcb]
2020-12-15 Added interfaces layouts
    [artix-dc-scm.kicad_pcb]
2020-12-15 Changed PCIe connection
    [fpga-banks.sch, pcie-conn.sch]
2020-12-15 Updated block diagram
    [artix-dc-scm.sch]
2020-12-15 Add local component libraries
    [artix-dc-scm.kicad_pcb, ddr3.sch, edge-connector.sch, ethernet.sch, fpga-banks.sch, fpga-power-supply.sch, interfaces.sch, pcie-conn.sch]
2020-12-16 Added VRs component placement, fix in 5V0 layout
    [artix-dc-scm.kicad_pcb, power-supply.sch]
2020-12-16 Removed DC connector
    [artix-dc-scm.kicad_pcb, power-supply.sch]
2020-12-16 Added PWR_EN optional pullup
    [power-supply.sch]
2020-12-16 Added testpad footprint to libs
2020-12-16 Removed debug headers
    [artix-dc-scm.kicad_pcb, fpga-banks.sch, interfaces.sch]
2020-12-16 Added power sequencer component placement, minor fixes in schematics
    [artix-dc-scm.kicad_pcb, power-supply.sch]
2020-12-16 Component placement done
    [artix-dc-scm.kicad_pcb, ddr3.sch, ethernet.sch, fpga-banks.sch, fpga-power-supply.sch]
2020-12-16 Redone RGMII FPGA connection
    [artix-dc-scm.kicad_pcb, fpga-banks.sch]
2020-12-17 Improved FPGA signals connection (WIP)
    [artix-dc-scm.kicad_pcb, fpga-banks.sch]
2020-12-17 Improved DDR3 related connection (WIP)
    [artix-dc-scm.kicad_pcb, ddr3.sch, interfaces.sch]
2020-12-18 Updated RoT and FLASH connections
    [artix-dc-scm.kicad_pcb, fpga-banks.sch, power-supply.sch, rot.sch]
2020-12-18 Improved DDR3 to FPGA connections (WIP)
    [artix-dc-scm.kicad_pcb, ddr3.sch, fpga-banks.sch, rot.sch]
2020-12-18 DDR3 to FPGA connections finished
    [artix-dc-scm.kicad_pcb, fpga-banks.sch]
2020-12-21 Added eMMC
    [interfaces.sch]
2020-12-22 Connected boot QSPI
    [fpga-banks.sch, rot.sch]
2020-12-22 Swapped RAS and CAS connection
    [ddr3.sch]
2020-12-22 Replaced PHY
    [ethernet.sch]
2020-12-22 Boot QSPI fixes, added status LEDs
    [fpga-banks.sch]
2020-12-23 FPGA related fixes, removed floating tags from Interfaces
    [fpga-banks.sch, fpga-power-supply.sch, interfaces.sch]
2020-12-23 Fixes to PCIe connector
    [pcie-conn.sch]
2020-12-23 Fixes after review (pin connections)
    [ddr3.sch, edge-connector.sch, ethernet.sch, fpga-banks.sch, fpga-power-supply.sch, pcie-conn.sch, power-supply.sch]
2020-12-23 Added USB client chip
    [ethernet.sch, fpga-banks.sch, interfaces.sch, pcie-conn.sch, power-supply.sch]
2020-12-24 New ICs component placement, replaced RJ45
    [artix-dc-scm.kicad_pcb, ethernet.sch]
2020-12-24 Fixed PCIe x1 connection
    [fpga-power-supply.sch, interfaces.sch]
2020-12-26 Reconnected DDR3
    [artix-dc-scm.kicad_pcb, ddr3.sch, fpga-banks.sch]
2020-12-26 Reconnected ethernet
    [artix-dc-scm.kicad_pcb, fpga-banks.sch]
2020-12-26 Reconnected USB
    [artix-dc-scm.kicad_pcb, fpga-banks.sch]
2020-12-26 Connected eMMC
    [artix-dc-scm.kicad_pcb, fpga-banks.sch]
2020-12-27 Reconnected interfaces
    [fpga-banks.sch, rot.sch]
2020-12-28 Finished connecting to FPGA
    [artix-dc-scm.kicad_pcb, fpga-banks.sch]
2020-12-28 Added SPI connector
    [artix-dc-scm.kicad_pcb, interfaces.sch, rot.sch]
2020-12-28 Added local libs
    [ethernet.sch, fpga-banks.sch, fpga-power-supply.sch, interfaces.sch, power-supply.sch, rot.sch]
2020-12-28 Updated libs
    [artix-dc-scm.kicad_pcb]
2020-12-28 Fix in libs
    [artix-dc-scm.kicad_pcb, pcie-conn.sch]
2020-12-28 Updated 3D vis and block diagram
    [artix-dc-scm.sch]
2020-12-28 Update component libraries
    [artix-dc-scm.kicad_pcb, ddr3.sch, edge-connector.sch, ethernet.sch, fpga-banks.sch, fpga-power-supply.sch, interfaces.sch, pcie-conn.sch]
2020-12-28 Update sheet titles, add PDF schematic
    [ddr3.sch, edge-connector.sch, ethernet.sch, fpga-banks.sch, fpga-power-supply.sch, interfaces.sch, pcie-conn.sch, power-supply.sch]
2020-12-28 Cleanup around Ethernet schematic
    [ethernet.sch]
2020-12-28 Clean M.2 sheet
    [artix-dc-scm.sch, pcie-conn.sch]
2020-12-28 RoT - cleanup
    [rot.sch]
2020-12-28 Update PDF schematic
2020-12-28 Add simple stackup description
    [artix-dc-scm.kicad_pcb]
2020-12-28 Update naming convention for PCIe
    [artix-dc-scm.kicad_pcb, edge-connector.sch, pcie-conn.sch]
2020-12-28 Add DRC for PCIe routing
    [artix-dc-scm.kicad_pcb]
2020-12-28 Add net labels to coupled PCIe lanes
    [artix-dc-scm.kicad_pcb, ethernet.sch, pcie-conn.sch]
2020-12-28 Add layout to M.2 PCIe
    [artix-dc-scm.kicad_pcb]
2020-12-28 Change M.2 description in README
    [artix-dc-scm.kicad_pcb, ethernet.sch]
2020-12-29 Specify eMMC model
    [artix-dc-scm.kicad_pcb, ethernet.sch, interfaces.sch]
2020-12-29 Add suggested MPS for ETH PHYs
    [ethernet.sch]
2020-12-29 Add BMC PCIe net classes
    [artix-dc-scm.kicad_pcb, edge-connector.sch, interfaces.sch]
2020-12-29 Define USB diff lanes
    [artix-dc-scm.kicad_pcb, edge-connector.sch, ethernet.sch, interfaces.sch]
2020-12-29 Route low speed HPM control signals
    [artix-dc-scm.kicad_pcb, interfaces.sch]
2020-12-29 Move M.2 up to meet component clearance
    [artix-dc-scm.kicad_pcb]
2020-12-29 Reconnect and route HPM control signals
    [artix-dc-scm.kicad_pcb, fpga-banks.sch]
2020-12-29 Swapped PHY, P-MOSFETs fix
    [artix-dc-scm.kicad_pcb, ethernet.sch, fpga-banks.sch, power-supply.sch]
2020-12-29 Rotate FPGA to match BMC PCIe lanes
    [artix-dc-scm.kicad_pcb]
2020-12-29 Added USB3300 controllers
    [interfaces.sch]
2020-12-29 Reroute control signals
    [artix-dc-scm.kicad_pcb]
2020-12-29 Update signal mapping
    [artix-dc-scm.kicad_pcb, fpga-banks.sch]
2020-12-29 Add layout for ULPI USB2
    [artix-dc-scm.kicad_pcb, fpga-banks.sch, interfaces.sch]
2020-12-30 Add layout for QSPI1
    [artix-dc-scm.kicad_pcb, fpga-banks.sch, interfaces.sch]
2020-12-30 Add layout for ULPI USB1
    [artix-dc-scm.kicad_pcb, fpga-banks.sch, interfaces.sch]
2020-12-30 Started routing SGPIO
    [artix-dc-scm.kicad_pcb]
2020-12-30 Remap DDR3 to B35
    [artix-dc-scm.kicad_pcb, fpga-banks.sch]
2020-12-30 Started DRC fanout
    [artix-dc-scm.kicad_pcb]
2020-12-30 Replaced and connected eMMC, replaced RJ45
    [artix-dc-scm.kicad_pcb, ethernet.sch, interfaces.sch]
2020-12-30 Connected ethernet
    [artix-dc-scm.kicad_pcb, fpga-banks.sch]
2020-12-30 Update RBIAS and filtering caps around ULPI USB controlers
    [interfaces.sch]
2020-12-31 DDR routing in progress
    [artix-dc-scm.kicad_pcb, ddr3.sch, interfaces.sch]
2020-12-31 Add DDR signal layout
    [artix-dc-scm.kicad_pcb]
2020-12-31 Fix swapped signals in QSPI1
    [artix-dc-scm.kicad_pcb, fpga-banks.sch]
2020-12-31 DDR3 expose power pads on vias
    [artix-dc-scm.kicad_pcb]
2020-12-31 Add filtering caps to DDR
    [artix-dc-scm.kicad_pcb, ddr3.sch]
2020-12-31 Route low speed IOs
    [artix-dc-scm.kicad_pcb]
2020-12-31 Reconnect eMMC, route low speed signals
    [artix-dc-scm.kicad_pcb, fpga-banks.sch, interfaces.sch]
2021-01-02 Route BMC PCIe
    [artix-dc-scm.kicad_pcb]
2021-01-02 Break route low I2C
    [artix-dc-scm.kicad_pcb]
2021-01-03 Route low speed IO towards FPGA
    [artix-dc-scm.kicad_pcb]
2021-01-04 Connect low speed IOs to FPGA
    [artix-dc-scm.kicad_pcb, fpga-banks.sch]
2021-01-04 Routed I3C signals
    [artix-dc-scm.kicad_pcb, fpga-banks.sch]
2021-01-04 move Flash ICs under RoT
    [artix-dc-scm.kicad_pcb]
2021-01-04 Fix PCB outline
    [artix-dc-scm.kicad_pcb]
2021-01-04 Cleaned up power sequencer
    [power-supply.sch]
2021-01-04 Connected user LEDs
    [fpga-banks.sch]
2021-01-04 Updated voltage supply labels, connected gpios left
    [ddr3.sch, fpga-banks.sch, fpga-power-supply.sch, power-supply.sch]
2021-01-04 Removed JTAG reference
    [interfaces.sch]
2021-01-04 Typo fix
    [edge-connector.sch, fpga-banks.sch]
2021-01-04 Replaced RoT connector with higher one
    [fpga-banks.sch, rot.sch]
2021-01-04 Add component placement
    [artix-dc-scm.kicad_pcb]
2021-01-04 Updated local libs
    [ddr3.sch, ethernet.sch, interfaces.sch]
2021-01-04 Fixed EN signals 0Rs
    [power-supply.sch]
2021-01-04 Fixed footprints on PCB
    [artix-dc-scm.kicad_pcb]
2021-01-04 Add connector cut-out
    [artix-dc-scm.kicad_pcb]
2021-01-04 Local lib fix
    [artix-dc-scm.kicad_pcb, interfaces.sch]
2021-01-04 Local libs fix
    [artix-dc-scm.kicad_pcb]
2021-01-05 Added power planes, set M.2 mounting hole position
    [artix-dc-scm.kicad_pcb, fpga-power-supply.sch]
2021-01-05 Added 5V0 plane
    [artix-dc-scm.kicad_pcb]
2021-01-05 Add JTAG routing
    [artix-dc-scm.kicad_pcb]
2021-01-05 Add RoT stood
    [artix-dc-scm.kicad_pcb, rot.sch]
2021-01-05 Add FPGA 100MHz clock source
    [artix-dc-scm.kicad_pcb, fpga-banks.sch, interfaces.sch]
2021-01-05 Add configuration modes routing
    [artix-dc-scm.kicad_pcb]
2021-01-06 Route configuration QSPI
    [artix-dc-scm.kicad_pcb, fpga-banks.sch]
2021-01-06 Update DDR3 termination
    [artix-dc-scm.kicad_pcb, ddr3.sch, fpga-banks.sch]
2021-01-06 minor fixes
    [artix-dc-scm.kicad_pcb]
2021-01-06 Update schematic notes, update SPI0 connection
    [artix-dc-scm.kicad_pcb, ddr3.sch, edge-connector.sch, fpga-banks.sch, interfaces.sch, pcie-conn.sch, rot.sch]
2021-01-07 Update filtering capacitors
    [artix-dc-scm.kicad_pcb, fpga-banks.sch, fpga-power-supply.sch]
2021-01-07 Update DDR3 filtering
    [artix-dc-scm.kicad_pcb, fpga-power-supply.sch]
2021-01-07 Update ETH lanes
    [artix-dc-scm.kicad_pcb]
2021-01-07 Routed RoT flashes
    [artix-dc-scm.kicad_pcb]
2021-01-07 Reconnect user LEDs
    [fpga-banks.sch]
2021-01-07 Add LEDs routing and oprimize flashes
    [artix-dc-scm.kicad_pcb]
2021-01-07 Add ethernet traces impedance tuning
    [artix-dc-scm.kicad_pcb]
2021-01-07 Fix ethernet traces DRC_errors and clock position
    [artix-dc-scm.kicad_pcb]
2021-01-07 Add 5V and GND routing
    [artix-dc-scm.kicad_pcb]
2021-01-08 Update layout around filtering caps
    [ddr3.sch, fpga-power-supply.sch, power-supply.sch]
2021-01-08 Update layout around DC/dC
    [power-supply.sch]
2021-01-08 Replaced 1V2 voltage regulator
    [ethernet.sch, power-supply.sch]
2021-01-08 Added 1V2 led indicator
    [power-supply.sch]
2021-01-08 Added 1V2 voltage regulator to PCB, routing
2021-01-08 Generated local libs
    [ddr3.sch, fpga-banks.sch, fpga-power-supply.sch, power-supply.sch, rot.sch]
2021-01-08 Cleaned up schematics
    [edge-connector.sch, ethernet.sch, fpga-banks.sch, fpga-power-supply.sch, interfaces.sch, power-supply.sch, rot.sch]
2021-01-11 Make DRC clean
    [power-supply.sch]
2021-01-12 Reconnect RGMII clocks to MRCC pins
    [fpga-banks.sch]
2021-01-13 Fix 1v0 translator
    [interfaces.sch, power-supply.sch]
2021-01-14 Update DDR3 length tunning
    [SSD.STEP, ddr3.sch]
2021-01-20 Fix unconected DVDDL pin and ETH LED labels
    [ethernet.sch]
2021-01-20 Add JTAG FTDI to schematic
    [interfaces.sch]
2021-01-22 Fix LED labels
    [ethernet.sch]
2021-01-22 Routed FTDI/JTAG
    [interfaces.sch]
2021-01-23 Update USB 3d model and add VBUS decoupling
    [interfaces.sch]
2021-01-25 Add logotypes and fix DRC errors
    [artix-dc-scm.sch]
2021-01-25 Bumped revision to 1.0.1 - replaced ROT connector, added ROT signals and connected to FPGA
    [artix-dc-scm.sch, ddr3.sch, edge-connector.sch, ethernet.sch, fpga-banks.sch, fpga-power-supply.sch, interfaces.sch, pcie-conn.sch]
2021-01-26 Update edge connector
    [artix-dc-scm.sch, edge-connector.sch, interfaces.sch, rot.sch]
2021-01-26 Add aux pwr connector
    [power-supply.sch]
2021-01-27 Fix USB3300 circuit
    -remove 1V8 connection
    -add capacitance at internal 1v8 regulators
    -apply changes to PCB
    [artix-dc-scm.sch, ddr3.sch, edge-connector.sch, ethernet.sch, fpga-banks.sch, fpga-power-supply.sch, interfaces.sch, pcie-conn.sch]
2021-01-27 Replace pull-up resistors
    [interfaces.sch]
2021-01-27 Fixed libs
    [artix-dc-scm.sch, ddr3.sch, edge-connector.sch, ethernet.sch, fpga-banks.sch, fpga-power-supply.sch, interfaces.sch, pcie-conn.sch]
2021-01-27 Fix eMMC pull-ups
    [interfaces.sch]
2021-01-27 update loclib
    [edge-connector.sch, interfaces.sch]
2021-01-27 Add pico lock connectors to pcb
    [power-supply.sch]
2021-01-27 Adjust RoT connector position
2021-01-27 Update TPM Pmod and add connector's designators
    [rot.sch]
2021-01-28 Add delay cap and connect 5V_PG with sequencer enable
    [power-supply.sch]
2021-01-28 Changed MDC/MDIO pullups. Changed ETH_LEDx polarity
    [ethernet.sch]
2021-01-28 Updated sequencer circuit
    [power-supply.sch]
2021-01-28 Added ESPI level translator
    [edge-connector.sch, interfaces.sch]
2021-01-28 Route orphaned signals
    [edge-connector.sch, fpga-banks.sch]
2021-01-28 Routed ESPI level shifter
    [fpga-banks.sch, interfaces.sch]
2021-01-29 Connected TPM control signals to FPGA
    [fpga-banks.sch, interfaces.sch, rot.sch]
2021-01-29 Added MEMS generators, updated local libs
    [ethernet.sch, interfaces.sch]
2021-01-29 Move I3C translator from bottom layer
    [interfaces.sch]
2021-01-29 Update DNP fields
    [fpga-banks.sch, interfaces.sch]
2021-01-29 Replace TVS diode
    [interfaces.sch]
2021-02-01 Fix in board design rules
2021-02-01 Bump release to 1.0.2
    [artix-dc-scm.sch, ddr3.sch, edge-connector.sch, ethernet.sch, fpga-banks.sch, fpga-power-supply.sch, interfaces.sch, pcie-conn.sch]
2021-02-01 Bump release to 1.0.3
    [artix-dc-scm.sch, ddr3.sch, edge-connector.sch, ethernet.sch, fpga-banks.sch, fpga-power-supply.sch, interfaces.sch, pcie-conn.sch]
2021-03-05 In5-Bot vias changed to TH. Bumped to 1.0.4
    [artix-dc-scm.sch, ddr3.sch, edge-connector.sch, ethernet.sch, fpga-banks.sch, fpga-power-supply.sch, interfaces.sch, pcie-conn.sch]
2021-03-16 Changed ETH clock to oscillator. Bumped to 1.0.5
    [artix-dc-scm.sch, ddr3.sch, edge-connector.sch, ethernet.sch, fpga-banks.sch, fpga-power-supply.sch, interfaces.sch, pcie-conn.sch]
2021-03-29 Change FT2232 into FT4232
    [ethernet.sch, interfaces.sch]
2021-03-29 Update layout, DRC clean
    [interfaces.sch]
2021-03-29 Add spare DBG_UART, DRC clean
    [fpga-banks.sch, interfaces.sch]
2021-03-29 Bump release to 1.0.6
    [artix-dc-scm.sch, ddr3.sch, edge-connector.sch, ethernet.sch, fpga-banks.sch, fpga-power-supply.sch, interfaces.sch, pcie-conn.sch]
2021-03-29 Update local libraries
    [ethernet.sch, interfaces.sch]
2021-04-02 Connected VUSB to FTDI's reset
    [interfaces.sch]
2021-04-02 Exposed copper and large mounting holes
    [artix-dc-scm.sch, interfaces.sch]
2021-05-03 Update schematics
2021-08-23 Assign DNP to DRAM pullup resistors
    [ddr3.sch]
2021-08-23 Mark U21 as DNP
    [interfaces.sch]
2022-09-26 Bump revision to 1.1.0
    [artix-dc-scm.sch, ddr3.sch, edge-connector.sch, ethernet.sch, fpga-banks.sch, fpga-power-supply.sch, interfaces.sch, pcie-conn.sch]
2022-09-26 Fix I2C5 and PCIE connections on J9 (schematic and library symbol fix)
    [edge-connector.sch]
2022-09-26 Reroute I2C5, PCIE and GND on J9, update footprint
2022-09-28 Update PDF schematics
2022-09-28 Initial conversion to KiCad 6.x format. Checked schematics after conversion. Cleared tracks and vias.
    [artix-dc-scm.kicad_sch, ddr3.kicad_sch, edge-connector.kicad_sch, ethernet.kicad_sch, fpga-banks.kicad_sch, fpga-power-supply.kicad_sch, interfaces.kicad_sch, pcie-conn.kicad_sch]
2022-09-29 Checked PCB. Routed one missing track in PROGRAM net. Checked DRC
2022-09-29 Removed KiCad 5.x legacy files
    [artix-dc-scm.sch, ddr3.sch, edge-connector.sch, ethernet.sch, fpga-banks.sch, fpga-power-supply.sch, interfaces.sch, pcie-conn.sch]
2022-09-29 Corrected all small errors. Fixed 3D model of USB connector
2023-02-09 Hide M.2 silkscreen outline on mechanical layer
2023-11-06 Introduce component standardization
    [artix-dc-scm.kicad_sch, ddr3.kicad_sch, edge-connector.kicad_sch, ethernet.kicad_sch, fpga-banks-13-16.kicad_sch, fpga-banks-34-25-cfg.kicad_sch, fpga-banks.kicad_sch, fpga-power-supply.kicad_sch]
2023-11-06 Bump revision to 1.1.1
    [artix-dc-scm.kicad_sch, ddr3.kicad_sch, edge-connector.kicad_sch, ethernet.kicad_sch, fpga-banks-13-16.kicad_sch, fpga-banks-34-25-cfg.kicad_sch, fpga-power-supply.kicad_sch, interfaces.kicad_sch]
2023-11-06 Fix schematic ERC errors. ERC clean
    [artix-dc-scm.kicad_sch, ddr3.kicad_sch, edge-connector.kicad_sch, ethernet.kicad_sch, fpga-banks-13-16.kicad_sch, fpga-banks-34-25-cfg.kicad_sch, fpga-power-supply.kicad_sch, interfaces.kicad_sch]
2023-11-06 Fix PCB DRC. DRC clean
2023-11-06 Fix board stackup
2023-11-07 Add OHP assets
    [stackup.csv]
